koko-PhyuHtwe/electronic-shifter-mbd/Shift-by-Wire_手册/01_项目概览与架构.md

# 第 1 章：项目概览与架构

## 项目定位

一句话：**用两颗车规 MCU + 一条 500kbps CAN，把一根电子摇杆变成能驱动实体换挡执行器的线控换挡系统，并把中间每一步的决策依据都暴露在串口屏上。**

面试定位提醒：这不是"点灯 + 串口打印"的教学工程。它同时具备四个量产项目的必备特征——**模型自动生成的控制逻辑、跨 MCU 的通信协议、双端独立的故障降级、以及可复现的调试记录**。

## 属性表

| 项目 | 内容 |
|---|---|
| 系统名称 | BMW Shift-by-Wire HIL 台架 |
| 拓扑 | 双 ECU：S32K144（采集 + 决策）↔ STM32G474VET6（执行 + 反馈） |
| 建模工具 | Simulink / Stateflow，`ert.tlc`，定步长 10ms |
| 生成代码 | `GearShift_Stateflow_step()` 纯函数式，被 FreeRTOS 任务以 10ms 调用 |
| 两片 RTOS | FreeRTOS（S32K 侧 7 任务 / G474 侧 5 线程，均为 CMSIS-RTOS v2 封装） |
| 通信 | Classic CAN 2.0A，500kbps，0x180 / 0x280 周期 10ms |
| 人机界面 | Nextion 串口屏，115200，指令式（`n0.val=` / `t0.txt=`） |
| 执行机构 | 舵机（PWM 50Hz，500~2500µs 对应 0~180°） |
| 安全机制 | 双端通信看门狗（0.5s / 2s 两级）、两侧独立看门狗（G474 1.25s / S32K 1.0s）、执行侧重启锁存 + 非法指令拦截、FAULT 状态 |
| 建模→实物闭环 | 摇杆三态（0/1/2）→ 状态机 → CAN → 舵机角度 → 屏幕显示 |

## 模块依赖图

```
                    ┌──────────────── S32K144 ────────────────┐
  摇杆 x/y (ADC) ──►│ sbw_adc.c ──► g_stick_x / g_stick_y      │
  刹车/油门 (ADC)──►│ (上电自校准 + 迟滞 + 4点滑窗)            │
  P键/解锁键(GPIO)►│ sbw_buttons.c ──► g_p_button/g_unlock    │
                    │                                          │
                    │        ┌──────────────┐                  │
                    │        │ rtos.c       │ 7 tasks          │
                    │        │ vTask_Gear   │ 10ms             │
                    │        └──────┬───────┘                  │
                    │               ▼                          │
                    │  GearShift_Stateflow_step()  ← 生成码    │
                    │   （6 顶层态 + M 内 6 子态）             │
                    │               │ current_gear             │
                    │               ▼                          │
                    │  sbw_can.c ──► 0x180 (10ms) ──┐          │
                    │  sbw_hmi.c ◄── Nextion 指令   │          │
                    │  sbw_veh.c ──► rpm/speed 仿真 │          │
                    └───────────────────────────────┼──────────┘
                                                    │ CAN 500k
                    ┌───────────────────────────────▼──────────┐
                    │            STM32G474VET6                 │
                    │  fdcan.c  RX FIFO0 过滤 0x180 ──► g_target│
                    │  app_freertos.c                          │
                    │    vTask_Servo_Control 10ms              │
                    │      GearToAngle() → ServoAngleToPulse() │
                    │      TIM3_CH1 / PE2 / 50Hz               │
                    │    vTask_CAN_Tx 10ms ──► 0x280           │
                    │    vTask_Debug 100ms ──► USART1          │
                    │  iwdg.c 1.25s 看门狗                     │
                    └──────────────────────────────────────────┘
```

## 核心文件速查

| 文件 | 行数 | 职责 | 面试必问 |
|---|---|---|---|
| `src/rtos.c` | 872 | 任务创建、输入映射、CAN 收发任务、演示面板 | 为什么 CANRx 优先级最高？ |
| `src/GearShift_Stateflow.c` | 721 | 生成码：全部换挡逻辑 | 生成码怎么读？`UnitDelay1` 干什么？ |
| `src/sbw_adc.c` | 317 | 4 路 ADC、滤波、摇杆自校准 | 为什么回中值 2936 不能用固定阈值？ |
| `src/sbw_can.c` | 315 | FlexCAN 初始化、环形队列、错误诊断 | 为什么用队列而不是直接读？ |
| `src/sbw_hmi.c` | 320 | Nextion 指令封装 + 接收解析 | `0xFF 0xFF 0xFF` 是什么？ |
| `src/sbw_buttons.c` | 80 | 双键消抖，极性参数化 | 为什么极性要做成参数？ |
| `src/sbw_veh.c` | 375 | 6 挡手动变速器物理模型 | 极速怎么标定的？ |
| `src/sbw_wdog.c` | 105 | WDOG 寄存器封装 + 复位原因采集 | 喂狗为什么挂心跳而不是 CAN？ |
| `STM32.../app_freertos.c` | 606 | 舵机 + 电机 PWM、CAN 组帧、喂狗 | 超时为什么是"冻结"不是"归位"？ |

## 版本演进

| 阶段 | 内容 | 状态 |
|---|---|---|
| P0 | Simulink/Stateflow 建模 + 生成码 | ✅ 完成（v1.24） |
| P1 | S32K144 采集侧集成（ADC/按键/CAN/HMI） | ✅ 完成 |
| P2 | G474 执行侧集成（CAN/舵机/IWDG） | ✅ 完成 |
| P3 | 双 ECU 联调（CAN 互通、换挡全链路） | ✅ 完成 |
| P4 | HIL 验证（摇杆校准、故障注入、演示面板） | 🟡 进行中 |
| P5 | CAN FD 升级（当前为 Classic CAN） | ⬜ 未开始 |

## 三个关键设计取舍

**① 为什么拆两颗 MCU，而不是一颗跑全部？**
一号理由不是算力，是**时序隔离**。舵机 PWM 由硬件定时器直接产生，但"什么时候改 CCR"发生在任务上下文；如果决策逻辑与舵机控制共享 CPU，任何一次 Stateflow 生成码里的长分支（M 挡 6 个子态的连锁判断）都会引入抖动。拆开后 G474 只需保证 10ms 周期内几十行代码，S32K 侧再怎么改模型都影响不到 PWM 的相位。副产品是**两个天然独立的故障判定点**——这正是功能安全想要的。

**② 为什么用 Classic CAN 500k 而不是 CAN FD？**
当前报文用掉 7 字节（档位/显示/生命计数/车速/油门/刹车），Classic CAN 的 8 字节刚好；500k 下单帧约 111 bit，10ms 周期单方向占用 2.2%、双向约 4.5%。上 FD 的收益要等到"把全部 ADC 原始值 + 诊断码 + 时间戳一起广播"才有意义，规划里放在 P5。

**③ 为什么换挡逻辑用 Stateflow 生成码，而不用手写 if-else？**
因为换挡是**状态机**而不是流程。手写 `if-else` 半年后没人能说清"从 M3 到 D 有几条路径"。Stateflow 保证每个状态的出边都在一张图里，且生成码天然带有"状态变量 + 转移守卫"的结构，便于 review 和覆盖率统计。代价是生成码可读性差，所以第 3 章专门讲怎么读它。

---

**下一章**：[02_硬件平台与引脚定义.md](./02_硬件平台与引脚定义.md) —— 两颗 MCU 的完整引脚、电气极性实测、以及"共地"这个害了两天的坑。
