koko-PhyuHtwe/electronic-shifter-mbd/Shift-by-Wire_手册/02_硬件平台与引脚定义.md

# 第 2 章：硬件平台与引脚定义

## 两颗 MCU 的基本盘

| 项目 | S32K144（采集 + 决策） | STM32G474VET6（执行 + 反馈） |
|---|---|---|
| 内核 | Cortex-M4F @80MHz | Cortex-M4F @80MHz（FPU + DSP） |
| Flash / RAM | 512KB / 64KB | 512KB / 128KB |
| 封装 | LQFP100 | LQFP100 |
| 时钟源 | 外部晶振 8MHz → PLL | 外部晶振 8MHz → PLL |
| 总线时钟 | CORE 80MHz / BUS 40MHz | SYSCLK 80MHz / PCLK1 80MHz |
| RTOS | FreeRTOS 10.x（heap 20KB，tick 1000Hz） | FreeRTOS 10.x（heap 4KB，tick 1000Hz） |
| 开发环境 | S32 Design Studio 3.6.8 | STM32CubeIDE |
| 配置工具 | NXP 配置工具（生成 `board/`） | CubeMX（生成 `Core/`） |

## S32K144 引脚表（LQFP100）

| 功能 | 引脚 | 脚号 | 模式 | 复用/上下拉 | 备注 |
|---|---|---|---|---|---|
| 摇杆 X | **PTC2** | 30 | Analog | ADC0_SE10 | 电位器滑臂 |
| 摇杆 Y | **PTC3** | 29 | Analog | ADC0_SE11 | 电位器滑臂 |
| 刹车踏板 | **PTA6** | 58 | Analog | ADC0_SE2 | 0~100% |
| 油门踏板 | **PTA7** | 57 | Analog | ADC0_SE3 | 0~100% |
| P 档键 | **PTB4** | 28 | GPIO 输入 | 内部**上拉** | **低有效**（实测松开 3.3V、按下 0V） |
| 解锁键 | **PTB2** | 48 | GPIO 输入 | 内部**下拉** | **高有效**（实测松开 0.76V、按下 3.3V） |
| CAN2 RX | **PTC16** | 44 | ALT3 | — | 接 CAN 收发器 RXD |
| CAN2 TX | **PTC17** | 43 | ALT3 | — | 接 CAN 收发器 TXD |
| HMI RX | **PTC6** | 81 | ALT2 | LPUART1_RX | 接屏幕 TX |
| HMI TX | **PTC7** | 80 | ALT2 | LPUART1_TX | 接屏幕 RX |
| 绿 LED | PTD16 | — | GPIO 输出 | — | CAN 初始化失败指示 |
| 蓝 LED | PTD15 | — | GPIO 输出 | — | 心跳 |
| 红 LED | PTD0 | — | GPIO 输出 | — | 备用 |
| 旧按键（未用） | PTC12/13/14 | — | GPIO 输入上拉 | — | 早期方案残留 |

> ADC 分辨率 12 位（0~4095），ADC0 时钟 8MHz，`sampleTime = 255`。

## STM32G474VET6 引脚表（LQFP100）

| 功能 | 引脚 | 模式 | 复用 | 备注 |
|---|---|---|---|---|
| 舵机 PWM | **PE2** | AF 推挽 | TIM3_CH1 / AF2 | 50Hz，500~2500µs |
| 电机 PWM | **PE3** | AF 推挽 | TIM3_CH2 / AF2 | 50Hz，1000~2000µs（标准 RC 电调信号） |
| CAN RX | **PB12** | AF | AF9 | 接 CAN 收发器 RXD（FDCAN2 外设，经典帧模式） |
| CAN TX | **PB13** | AF | AF9 | 接 CAN 收发器 TXD |
| 调试 TX | PA9 | AF | USART1 / AF7 | 115200-8-N-1 |
| 调试 RX | PA10 | AF | USART1 / AF7 | |
| 蓝 LED | PE0 | GPIO 输出 | — | 1s 心跳 |
| 绿 LED | PE1 | GPIO 输出 | — | CAN 状态指示 |
| ADC1 IN1~IN4 | — | Analog | — | DMA 到 `g_adc_buffer[4]`，**当前未消费** |

## 外部器件清单

| 器件 | 接口 | 关键参数 |
|---|---|---|
| 摇杆（双轴电位器） | S32K ADC0_SE10/SE11 | 3.3V 供电，回中约 2900~3050（**不是 2048**） |
| 刹车踏板（霍尔/电位器） | ADC0_SE2 | 0~100%，>30% 才算"踩下" |
| 油门踏板 | ADC0_SE3 | 0~100%，死区以下 200 counts 视为 0 |
| 解锁键（自复位） | PTB2 | 按下接 3.3V，板上有外部下拉 |
| P 档键（自复位） | PTB4 | 按下接 GND，板上有外部上拉 |
| 舵机 | G474 PE2 | 5V 供电，PWM 50Hz，0°=换挡机构 P 位 |
| 电机 + 电调 | G474 PE3 | Sunnysky X2212 KV1400 + 好盈 20A 电调，信号线接 PE3，**黑线必须共地** |
| 串口屏 | S32K PTC6/PTC7 | Nextion，115200，**工程文件为私有二进制** |
| CAN 收发器 ×2 | 两侧各一 | 3.3V 逻辑，终端电阻 120Ω ×2 |

## 电气极性：两个按键为什么不一样

这是本项目最容易被误判的地方，两个键在同一块板子上，极性相反：

| 按键 | 松开实测 | 按下实测 | 结论 | 配置 |
|---|---|---|---|---|
| 解锁键 PTB2 | **0.76 V** | 3.3 V | 高有效 | 内部下拉（把 0.76V 压到 ~0V） |
| P 档键 PTB4 | **3.3 V** | 0 V | 低有效 | 内部上拉 |

0.76V 的来历：按键接 3.3V，板上有 ~10k 外部下拉，芯片内部又是 ~30k 上拉，两者分压。关键结论是：**0.76V 低于 MCU 的 VIL 典型值（约 0.99V）但余量只有 0.23V**，任何噪声都可能误触发。把内部上拉改成下拉后，静态电平被压到 ~0V，噪声余量从 0.23V 提升到 1V 以上。

> 代码里这个"极性"做成了**编译期常量**（`BTN_P_ACTIVE_LEVEL` / `BTN_UNLOCK_ACTIVE_LEVEL`），而不是硬编码 `!HAL_GPIO_ReadPin(...)`。理由见第 11 章踩坑记录——硬编码极性导致过两次"按键永远按下 / 永远不响应"的误诊。

## 三个硬件层面的坑

**① 共地**：摇杆电位器的 GND 悬空时，ADC 读数只有在"两轴同时构成回路"（对角推动）时才正常。表现是"必须斜着推才有反应"。这不是软件问题，任何滤波都救不了——**模拟量的第一课是共地**。

**② 舵机电源与逻辑电源分离**：舵机堵转电流可达 1A 以上，如果与 MCU 共用 5V LDO，换挡瞬间会拉低 MCU 电源造成复位。台架上必须给舵机独立 5V。电调的 BEC 5V 同理，**不要与板子 5V 并联**（拔红线或单独供电，但必须共地）。

**③ CAN 终端电阻**：两侧各 120Ω，总线两端各一个。只在一端装或两端都不装时，短距离还能通信，但示波器上能看到明显的振铃，长线必挂。

---

**上一章**：[01_项目概览与架构.md](./01_项目概览与架构.md) ｜ **下一章**：[03_Stateflow模型与代码生成.md](./03_Stateflow模型与代码生成.md)
