koko-PhyuHtwe/electronic-shifter-mbd/Shift-by-Wire_手册/14_文件组织指南.md

# 第 14 章：文件组织指南

## 顶层结构

```
bmw-shift-by-wire-hil/
├── README.md                  # 项目入口（架构 / 协议 / 上手指南）
├── MATLAB/                    # Simulink/Stateflow 模型与生成码
├── S32K144/                   # 采集 + 决策侧
└── STM32G474VET6/             # 执行 + 反馈侧
```

> 本手册现在放在**工程同级的** `Documents/Shift-by-Wire_手册/`，不带在仓库里——方便单独拷给面试官或打印，也避免和代码混在一起。

## MATLAB/

| 文件 | 作用 | 能否删 |
|---|---|---|
| `GearShift_Stateflow.slx` | **模型源文件**（约 230KB，v1.24） | ❌ 不能，唯一原件 |
| `GearShift_Stateflow_ert_rtw/` | Ctrl+B 的产物目录（`.c/.h/_private.h/_types.h/rtwtypes.h` 都在这里） | ⚠️ 拷进 `src/` 后可以删，但留着方便下次对比 |
| `slprj/`、`*.slxc`、`binfo.mat`、`codeInfo.mat`、`bundle*.js` | Simulink 构建缓存（66 个文件，约 2.9MB） | ✅ 可删（重新生成会再出现） |

> **注意**：`MATLAB/GearShift_Stateflow_ert_rtw/` 下的 `.c/.h` 与 `S32K144/freertos_s32k144/src/` 下的同名文件是**两份副本**。编译用的是 `src/` 那份，改完模型要手动拷过去——这是当前流程最脆弱的一环，忘了拷就会出现"模型改了但幺幺没变"。

## S32K144/freertos_s32k144/src/ —— 手写代码

| 文件 | 行数 | 作用 | 关键点 |
|---|---|---|---|
| `main.c` | 41 | 只有 `rtos_start()` + 不会返回的兜底循环 | 尽量空，避免逻辑分散 |
| `rtos.c` | 872 | 7 任务、输入映射、CAN 收发、活体计数喂狗、演示面板 | 系统主骨架 |
| `sbw_adc.c/.h` | 317 / 60 | 4 路 ADC、滤波、摇杆自校准 | `ADC_ToStickPos()` 是核心 |
| `sbw_can.c/.h` | 315 / 130 | FlexCAN 初始化、环形队列、错误状态与计数器 | `CAN_Init()` 失败点亮绿 LED |
| `sbw_hmi.c/.h` | 320 / 73 | Nextion 指令收发 | 三个 `0xFF` 帧尾 |
| `sbw_buttons.c/.h` | 80 / 58 | 双键消抖，极性参数化 | `activeLevel` 参数 |
| `sbw_veh.c/.h` | 375 / 47 | 6 挡手动车辆模型 | `VehModel_Update(gearCode)` |
| `sbw_wdog.c/.h` | 105 / 52 | WDOG 寄存器级封装（1.0s）+ 复位原因采集 | 喂狗由心跳任务在活体检查后调用 |
| `GearShift_Stateflow.c` | 721 | 生成码：全部换挡逻辑（模型 v1.24，无手改） | 不要手改，改模型 |
| `GearShift_Stateflow.h` | 138 | `ExtU`（9 进）/ `ExtY`（2 出）定义 | 接口变更会编译报错 |
| `GearShift_Stateflow_private.h` | 26 | 生成码私有定义 | |
| `GearShift_Stateflow_types.h` | 28 | 生成码类型 | |
| `rtwtypes.h` | 176 | Simulink 基础类型 | |
| `BoardDefines.h` | 30 | 板级宏 | |

## S32K144/freertos_s32k144/board/ —— 配置工具生成

| 文件 | 作用 | 改法 |
|---|---|---|
| `clock_config.c/.h` | 时钟树（CORE 80MHz / BUS 40MHz / ADC0 8MHz） | 用配置工具改，不要手改 |
| `pin_mux.c/.h` | 引脚复用、上下拉 | **可以手改**（本项目改过 PTB2 的上下拉） |
| `peripherals_adc_config_1.c/.h` | ADC 通道配置（4 个通道结构体） | 配置工具 |
| `peripherals_flexcan_config_1.c/.h` | FlexCAN 位时序 | 配置工具 |
| `peripherals_lpuart_1.c/.h` | LPUART1（HMI） | 配置工具 |
| `peripherals_FreeRTOS.c/.h` | FreeRTOS 配置包装 | 配置工具 |
| `peripherals_osif_1.c/.h` | OSIF（裸机/RTOS 抽象） | 配置工具 |
| `sdk_project_config.h` | 汇总包含所有外设配置 | **已经包含 pin_mux.h**（所以别重复 include） |
| `FreeRTOSConfig.h` | heap 20KB、tick 1000Hz、优先级 5 | 手改（注意 `configLIBRARY_MAX_SYSCALL_INTERRUPT_PRIORITY`） |

## STM32G474VET6/ShiftByWire_HIL/Core/Src/

| 文件 | 行数 | 作用 | 关键点 |
|---|---|---|---|
| `main.c` | 237 | 初始化顺序 + `osKernelStart()` | `MX_TIM3_Init` 里已启动 CH1；CH2 由 `Motor_Init()` 启动 |
| `app_freertos.c` | 606 | 舵机控制、电机 PWM、CAN 组帧、喂狗 | `last_gear = 0xFF` 初值 |
| `fdcan.c` | 292 | CAN 500kbps、过滤器、**bus-off 自愈回调** | `AutoRetransmission = DISABLE` |
| `tim.c` | 152 | TIM3 50Hz PWM，PE2/PE3 AF2 | PSC 79 / ARR 19999 |
| `iwdg.c` | 59 | 独立看门狗 1.25s | Prescaler 64 / Reload 625 |
| `adc.c` | 210 | ADC1 4 通道 DMA | **采集了但没消费** |
| `usart.c` | 153 | USART1 115200 | 调试打印 |
| `gpio.c` | 67 | LED | |
| `stm32g4xx_it.c` | 208 | 中断向量 | CAN/SysTick |
| `stm32g4xx_hal_timebase_tim.c` | 127 | HAL 时基（TIM2） | |
| `system_stm32g4xx.c` | 287 | 时钟初始化 | |
| `dma.c` | 56 | DMA | ADC 用 |
| `stm32g4xx_hal_msp.c` | 87 | HAL MSP | |

> G474 侧除了 USER CODE 区，**其余都是 CubeMX 生成物**。要改外设就回 CubeMX 改，否则下次生成会被覆盖。

## 哪些文件可以安全删除

| 文件 | 理由 |
|---|---|
| `MATLAB/slprj/`、`*.slxc`、`*.mat`、`bundle*.js` | 构建缓存（约 2.9MB） |
| `Debug_FLASH/` 下的 `.o` / `.d` / `.elf` | 编译产物（但保留 `.args`，命令行复编译要用） |
| `STM32G474VET6/.../Drivers/` 里没用到的 HAL 模块 | 体积大头（全工程 158MB） |
| `S32K144/.../Debug_FLASH/src/*.d` | 依赖文件，重新编译会生成 |

## 哪些文件绝对不能删

1. `MATLAB/GearShift_Stateflow.slx` —— 模型唯一原件。
2. `board/sdk_project_config.h` —— 所有外设配置的入口，删了编译全崩。
3. `board/FreeRTOSConfig.h` —— 优先级和堆配置，直接影响调度行为。
4. `src/GearShift_Stateflow.c` —— 即便能重新生成，也要保证仓库里有一份可编译的。

## 命名与目录约定

- **模块前缀**：`sbw_` 表示"本项目自写的业务模块"，与 NXP/ST 生成文件（`peripherals_*`、`MX_*`、`board/`）区分开。
- **生成文件不手改**：`GearShift_Stateflow.*`、`board/clock_config.*`、`board/peripherals_*` 都是生成的。唯一例外是 `pin_mux.c`（改上下拉），因为配置工具的 UI 不好用。
- **一行一个职责**：`rtos.c` 里每个任务函数只做一件事，不做嵌套调用，方便定位问题。
- **命名**：函数 `模块_动作`（`ADC_SampleAll`）、全局量 `g_` 前缀、文件内静态量 `s_` 前缀、宏全大写且数值带 `U` 后缀。
- **格式**：S32K 侧 LF + 4 空格，G474 侧跟随 ST 的 CRLF + 2 空格；大括号 Allman 风格；只用 `/* */`，不用 `//`；行宽 ≤100。

## 编译产物与 `.args`

`Debug_FLASH/src/GearShift_Stateflow.args` 是 S32DS 生成的编译参数文件（include 路径、宏定义、优化选项）。它的用途是**不开 IDE 也能编译单个文件**：

```powershell
cd S32K144/freertos_s32k144/Debug_FLASH
arm-none-eabi-gcc.exe @src/GearShift_Stateflow.args -o out.o ..\src\rtos.c
```

这在快速验证语法错误时非常有用——IDE 启动要 30 秒，命令行编译 2 秒。

---

**上一章**：[13_面试问答.md](./13_面试问答.md) ｜ **返回**：[README.md](./README.md)
