koko-PhyuHtwe/electronic-shifter-mbd/Shift-by-Wire_手册/12_工程规范与改进方向.md

# 第 12 章：工程规范与改进方向

## 已实现（可以拍胸脯的）

| 能力 | 证据 |
|---|---|
| Stateflow 建模 + 自动生成码落地 | `GearShift_Stateflow.c` 721 行，被 10ms 任务调用 |
| 6 状态机 + 6 手动子态 | P/R/N/D/M1~M6/FAULT 全部可达 |
| 双 MCU 跨 CAN 通信 | 0x180 / 0x280，10ms 周期，实测互通 |
| 摇杆上电自校准 + 迟滞 | 回中 2936 也能正确判三态 |
| 4 路 ADC + 滤波 + 死区 | 刹车/油门/摇杆 X/Y |
| 按键极性参数化 + 消抖 | 30ms 消抖，两个相反极性的键共存 |
| 串口屏 HMI | 数字/文本控件、指令封装、接收解析 |
| 双端通信看门狗 | G474 500ms 冻结 / S32K 2s 进 FAULT |
| 独立看门狗 | G474 IWDG 1.25s / S32K WDOG 1.0s（任务活体检测，**代码就绪、当前关闭**） |
| 6 挡手动车辆模型 | 齿比/扭矩曲线/半联动/断油/发动机制动 |
| 演示面板 | 大档位 + 事件日志，横屏布局 |
| 电机通道 | TIM3_CH2 → 电调，0x180 B5 传油门，3s 解锁 + 见过 B5==0 |
| 动力安全四道闸 | 失联/FAULT 软切（锁存）、挡位门、刹车优先、台架限幅 |

## 已实现（曾经的风险，现已关闭）

| 曾有的缺口 | 现在的做法 | 代码位置 |
|---|---|---|
| 行驶中复位 → 回 P → 舵机拉到 P | 0x180 增车速字节；G474 用「life 计数不连续」+「车速单帧暴跌 >10km/h」判定对端重启，行驶中触发则锁存拒绝 P/R，并上报 `EXEC LOCK` | `Core/Src/fdcan.c` 回调、`Core/Src/app_freertos.c` 舵机任务 |
| S32K 调度器卡死 → 永久失去响应 | WDOG 1.0s + 心跳任务的五任务活体检测；喂狗与 CAN 状态无关，避免断线引起复位循环 | `src/sbw_wdog.c`、`src/rtos.c` `vTask_Heartbeat` |

## 未实现（必须诚实标注的）

| 缺口 | 影响 | 优先级 |
|---|---|---|
| 舵机无位置反馈 | 舵机卡死/断线在软件上不可见 | **高** |
| 无复位原因计数 | 反复复位时无"锁定维护"出口（工业做法：后备寄存器计数 + DTC） | 中 |
| S32K 侧不校验 life_counter | 无法检测丢帧/重复帧（G474 侧已用于重启检测） | 中 |
| 无 E2E 保护（CRC/DataID） | 不满足 ASIL-B 的通信安全 | 中 |
| 无 DTC / 诊断服务 | 无法读故障码 | 中 |
| 无 Bootloader | 不能 OTA 刷写 | 低（已有独立 UDS 工程） |
| P→N 直接通路缺失 | 与真车行为有差异 | 低 |
| M 模式无 N 出口 | 只能回 D 或 P | 低 |
| CAN FD 未升级 | 带宽利用率低 | 低（P5 规划） |
| G474 ADC 采集了不用 | 死代码 | 低 |

## 代码规范

### 命名

| 前缀/形式 | 含义 | 例 |
|---|---|-----|
| `g_` | 全局变量 | `g_current_gear` |
| `s_` | 文件内静态变量 | `s_throttle` |
| `vTask_` | FreeRTOS 任务函数 | `vTask_Gear_Logic` |
| `MX_` | CubeMX 生成 | `MX_FDCAN2_Init` |
| `sbw_` | 本项目自写模块 | `sbw_adc.c` |
| 全大写 | 宏 | `ADC_DEAD_LOW` |
| `Module_Function` | 模块内函数 | `ADC_ToStickPos` |

### 三条硬规则

1. **跨任务共享的变量必须 `volatile`**。当前全是 8/16 位整数，读写原子；若将来加结构体，必须改用队列。
2. **ISR 里只做搬运，不做业务**。CAN 中断只入队，HMI 中断只填环形缓冲。
3. **极性、阈值、周期一律宏定义在头文件**，不写魔法数字。`git diff` 要能一眼看出"改了哪个阈值"。

### 编译零警告

S32K 侧 9 个源文件用 `arm-none-eabi-gcc` 单独编译全部 0 warning。命令行复编译方法见 README。**提交前必须零警告**——警告里藏着真实的类型截断和未初始化变量。

## 改进路线图

### 短期（P4 收尾，1~2 天）

1. ~~**0x180 加车速字节**~~：已完成（`B4 = vehicle_speed` + G474 侧重启检测与拒绝执行）。
2. ~~**启用 S32K WDOG**~~：代码已完成（`sbw_wdog.c`，1.0s，心跳任务五任务活体检测后喂），**当前 `WDOG_ENABLE` 还是 `0U`**——排查复位循环时关的，稳定后改回 `1U` 并跑一遍故障注入。
3. **跑完动力软切的 A/B/C 测试**：拔 CAN 软切、插回不自动恢复、松脚重踩恢复。
4. **接收侧校验 life_counter**：连续 3 次不 +1 → 计一次通信异常（G474 侧已用于重启检测，S32K 侧尚未做）。
5. **复位原因计数**：后备寄存器存上电次数，10 分钟内 >3 次进锁定维护态。

### 中期（P4.5，1 周）

6. **加舵机反馈电位器**：接到 G474 ADC1 IN1，`g_adc_buffer[0]` 与目标角度比较，偏差 >5° 持续 200ms → `STATUS_SERVO_FAULT`。
7. **加 DTC 表**：至少 6 条（通信丢失、超时、舵机偏差、摇杆开路、欠压、看门狗复位）。通过 HMI 或调试串口读。

> status 位回传已经做完了：`0x280.B2` 的 bit1/bit3/bit4/bit5 在 S32K 屏上分别显示为 `EXEC LOCK` / `PWR CUT` / `NO DRIVE` / `BRAKE CUT`。

### 长期（P5）

8. **CAN FD 升级**：把载荷从 7 字节扩到"全部原始 ADC + 诊断码 + 时间戳"，周期从 10ms 降到 5ms。
9. **E2E 保护**：CRC8 + 计数器 + DataID，符合 AUTOSAR E2E Profile 1/2。
10. **Bootloader**：复用已完成的 UDS Bootloader 工程（`S32K144_UDS_Bootloader`），加 OTA 刷写。
11. **ASIL 分析**：做 HARA，识别"非预期换入 P"的 ASIL 等级，反推安全机制。

## 量产还差什么（面试常问）

如果问"这个项目离量产还有多远"，按这个顺序答：

1. **功能安全**：当前无 HARA、无 FMEA、无安全手册。至少要识别出"非预期换挡"的 ASIL 等级，并证明现有的互锁与超时机制能满足。
2. **E2E 通信保护**：CAN 硬件 CRC 不够，需要应用层 CRC + 计数器，能检出"内容正确但顺序错乱"的帧。
3. **传感器冗余**：摇杆单路模拟量，一路断线就失去输入。量产需要双路互检或数字编码器。
4. **执行器闭环**：舵机必须带位置反馈，"指令=实际"才能被证明。
5. **诊断与可维护性**：DTC、冻结帧、UDS 服务（0x19/0x22/0x2E）、Bootloader。
6. **环境与 EMC**：温度循环、振动、ESD、BCI。台架上跑通不代表车上能跑。
7. **软件过程**：MISRA C、单元测试覆盖率、静态分析（Polyspace/Coverity）、需求可追溯性。

## 这个项目真正证明了什么

不是"我会用 FreeRTOS"，而是：

- **能把一个 Simulink 模型变成两片 MCU 上跑起来的实物**——闭环从建模到执行器。
- **能在没有逻辑分析仪、只有万用表和串口屏的条件下定位问题**——坑 #4 的两天和坑 #6 的"没烧录"。
- **知道哪里没做完，以及为什么没做完**——这份清单本身就是工程能力的证据。

---

**上一章**：[11_调试踩坑记录.md](./11_调试踩坑记录.md) ｜ **下一章**：[13_面试问答.md](./13_面试问答.md)
