koko-PhyuHtwe/electronic-shifter-mbd/.archify/explainer-sbw-hil-20261107-000500/t1.md

# 测试 {#t}

结论。

@answer scope="测试"
@meta locale=zh-CN style=clean

@source readme title="README" path=README.md

## 面板 {#p}

文字。[]
