koko-PhyuHtwe/electronic-shifter-mbd/.archify/explainer-sbw-hil-20261107-000500/full-light.png

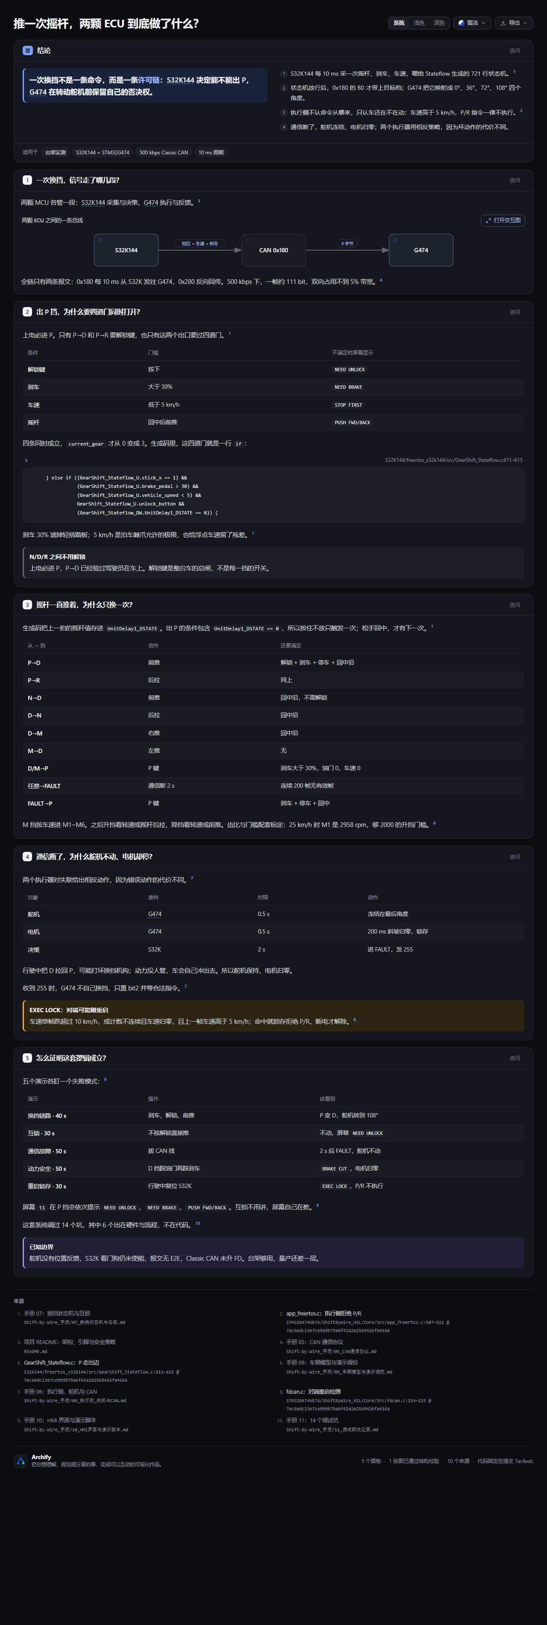
.archify/explainer-sbw-hil-20261107-000500/full-light.png
