koko-PhyuHtwe/electronic-shifter-mbd/.archify/explainer-sbw-hil-20261107-000500/shots2/shift-by-wire-hil.visual-check.1280x900.dark.png

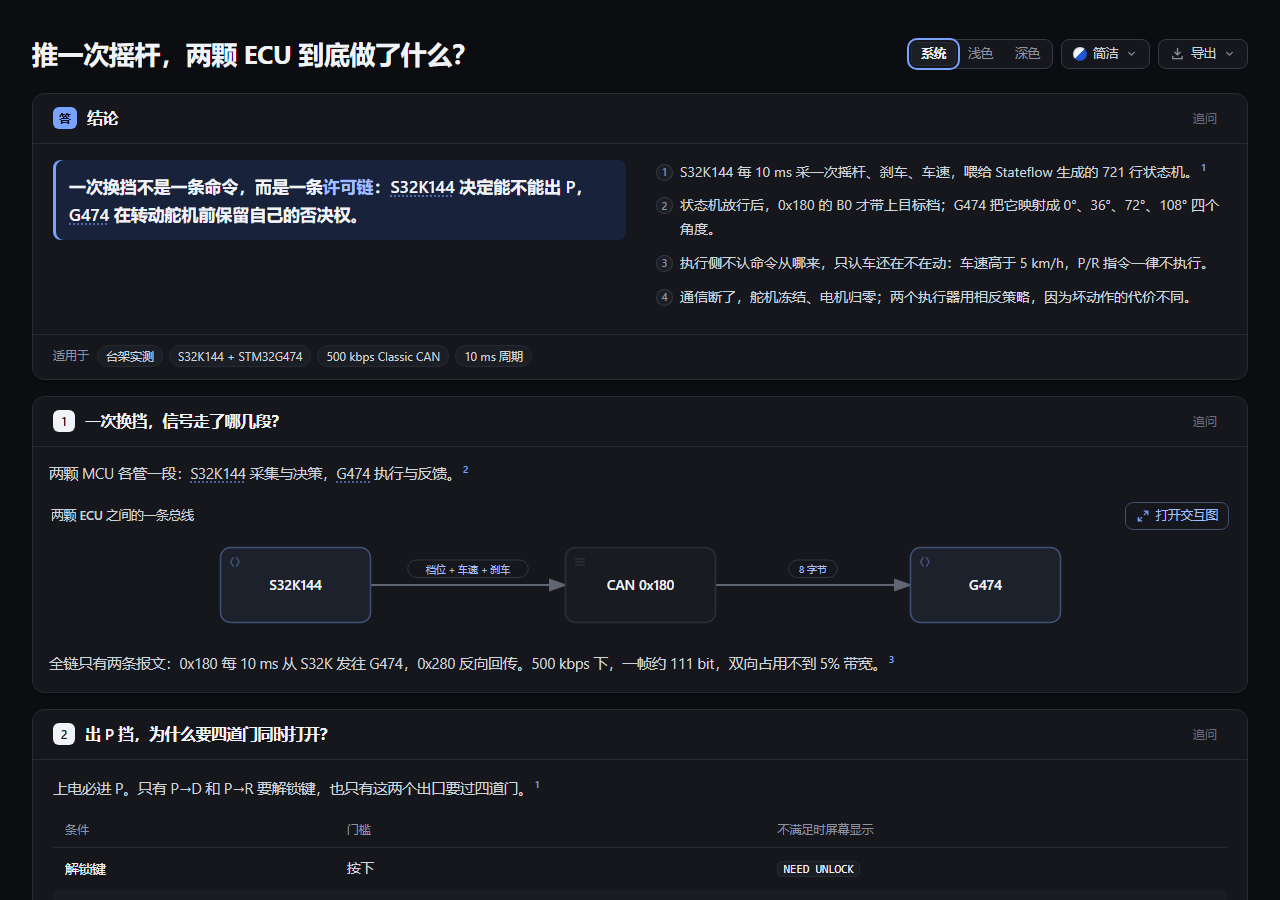
.archify/explainer-sbw-hil-20261107-000500/shots2/shift-by-wire-hil.visual-check.1280x900.dark.png
