koko-PhyuHtwe/electronic-shifter-mbd/.archify/explainer-sbw-hil-demo-20261107-003300/full.png

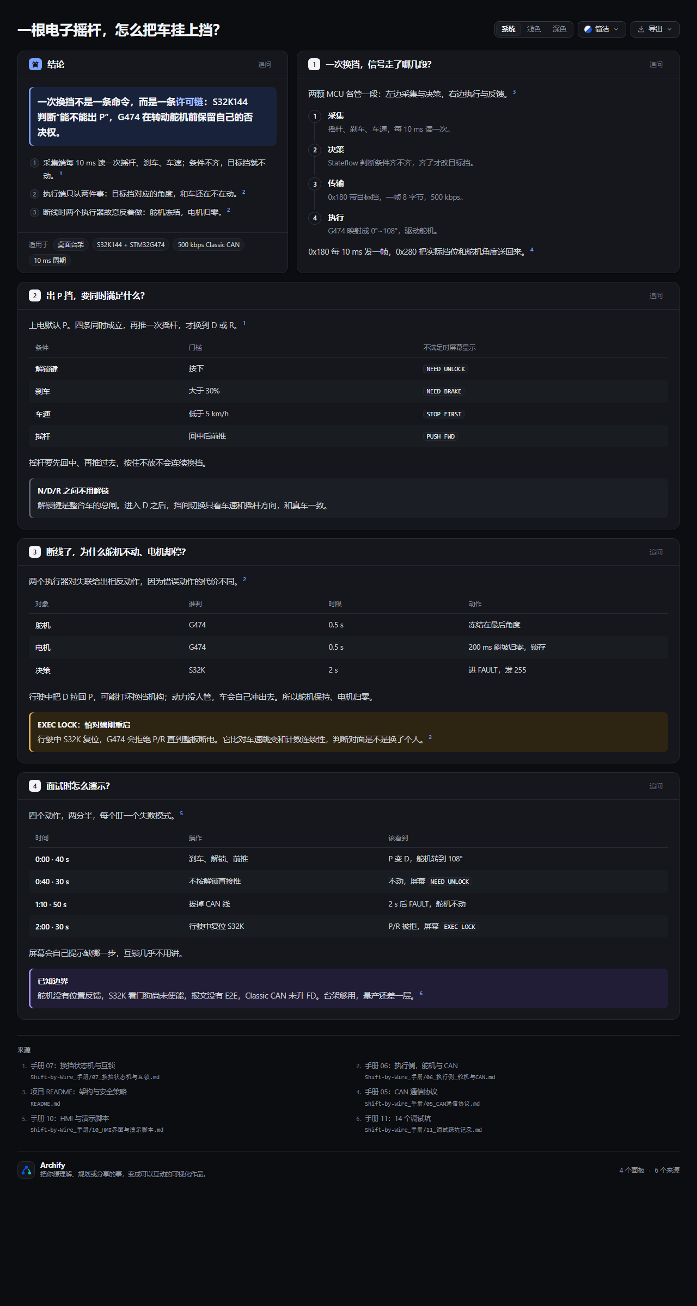
.archify/explainer-sbw-hil-demo-20261107-003300/full.png
