koko-PhyuHtwe/electronic-shifter-mbd/.archify/explainer-sbw-hil-demo-20261107-003300/shots/shift-by-wire-hil-demo.visual-check.1280x900.dark.png

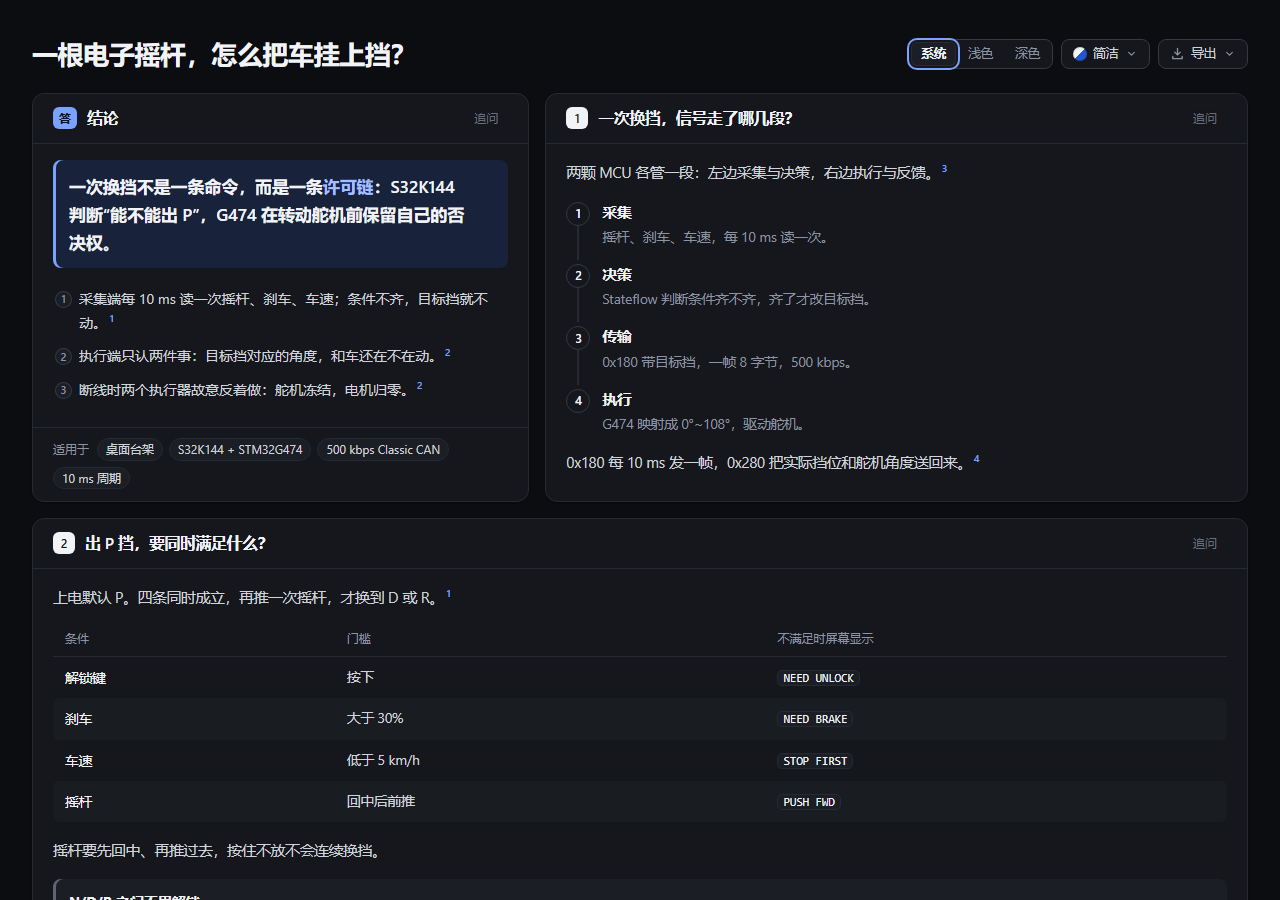
.archify/explainer-sbw-hil-demo-20261107-003300/shots/shift-by-wire-hil-demo.visual-check.1280x900.dark.png
