koko-PhyuHtwe/electronic-shifter-mbd/.archify/final.png

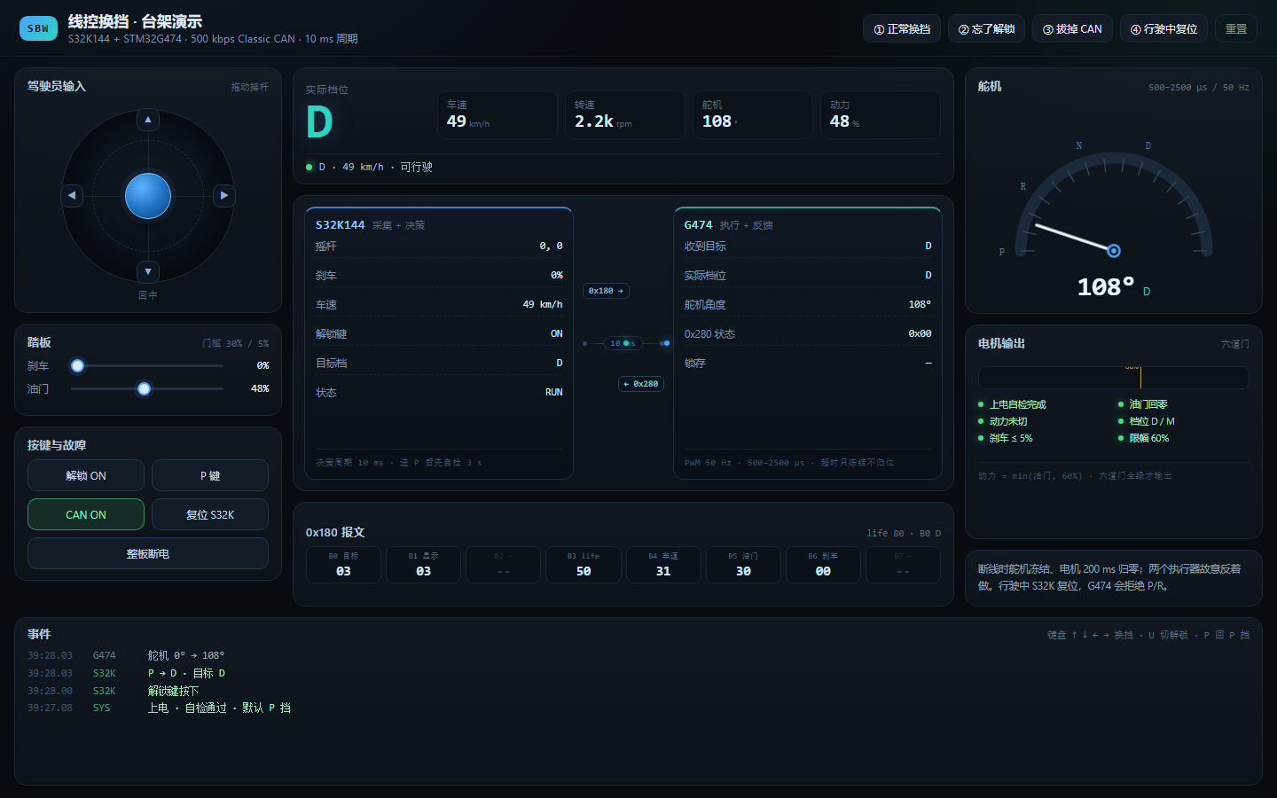
.archify/final.png
