koko-PhyuHtwe/electronic-shifter-mbd/.archify/top.png

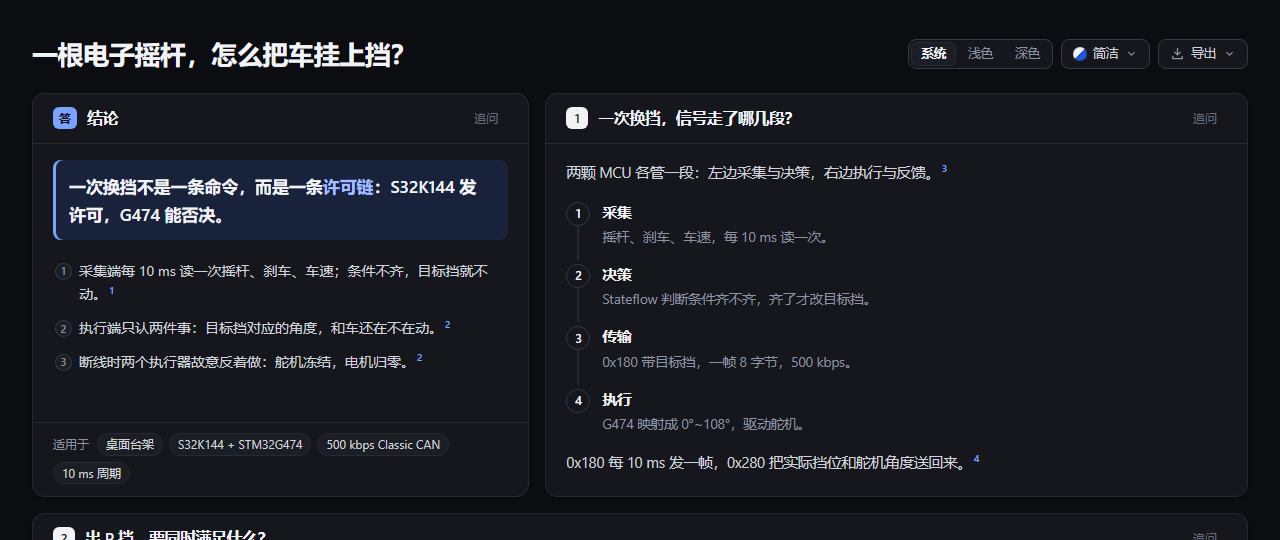
.archify/top.png
