koko-PhyuHtwe/electronic-shifter-mbd/.archify/explainer-sbw-hil-demo-20261107-003300/measure.html

跳至正文

# 一根电子摇杆，怎么把车挂上挡？

系统浅色深色

简洁

简洁杂志产品网格

导出

长图

PNG最清晰WebP体积最小JPG兼容最好

打印 / PDF

答

## 结论

一次换挡不是一条命令，而是一条许可链：S32K144 判断“能不能出 P”，G474 在转动舵机前保留自己的否决权。

1. 采集端每 10 ms 读一次摇杆、刹车、车速；条件不齐，目标挡就不动。¹
2. 执行端只认两件事：目标挡对应的角度，和车还在不在动。²
3. 断线时两个执行器故意反着做：舵机冻结，电机归零。²

适用于桌面台架S32K144 + STM32G474500 kbps Classic CAN10 ms 周期

1

## 一次换挡，信号走了哪几段？

两颗 MCU 各管一段：左边采集与决策，右边执行与反馈。³

两颗 ECU 之间的一条总线打开交互图

图的结构

- S32K144 s32k
- CAN 0x180 bus
- G474 g474
- s32k → bus · 目标挡 + 车速
- bus → g474 · 8 字节

0x180 每 10 ms 发一帧，0x280 把实际挡位和舵机角度送回来。⁴

2

## 出 P 挡，要同时满足什么？

上电默认 P。四条同时成立，再推一次摇杆，才换到 D 或 R。¹

条件 | 门槛 | 不满足时屏幕显示
解锁键 | 按下 | NEED UNLOCK
刹车 | 大于 30% | NEED BRAKE
车速 | 低于 5 km/h | STOP FIRST
摇杆 | 回中后前推 | PUSH FWD

摇杆要先回中、再推过去，按住不放不会连续换挡。

### N/D/R 之间不用解锁

解锁键是整台车的总闸。进入 D 之后，挡间切换只看车速和摇杆方向，和真车一致。

3

## 断线了，为什么舵机不动、电机却停？

两个执行器对失联给出相反动作，因为错误动作的代价不同。²

对象 | 谁判 | 时限 | 动作
舵机 | G474 | 0.5 s | 冻结在最后角度
电机 | G474 | 0.5 s | 200 ms 斜坡归零，锁存
决策 | S32K | 2 s | 进 FAULT，发 255

行驶中把 D 拉回 P，可能打坏换挡机构；动力没人管，车会自己冲出去。所以舵机保持、电机归零。

### EXEC LOCK：怕对端刚重启

行驶中 S32K 复位，G474 会拒绝 P/R 直到整板断电。它比对车速跳变和计数连续性，判断对面是不是换了个人。²

4

## 面试时怎么演示？

四个动作，两分半，每个盯一个失败模式。⁵

时间 | 操作 | 该看到
0:00 · 40 s | 刹车、解锁、前推 | P 变 D，舵机转到 108°
0:40 · 30 s | 不按解锁直接推 | 不动，屏幕 NEED UNLOCK
1:10 · 50 s | 拔掉 CAN 线 | 2 s 后 FAULT，舵机不动
2:00 · 30 s | 行驶中复位 S32K | P/R 被拒，屏幕 EXEC LOCK

屏幕会自己提示缺哪一步，互锁几乎不用讲。

### 已知边界

舵机没有位置反馈，S32K 看门狗尚未使能，报文没有 E2E，Classic CAN 未升 FD。台架够用，量产还差一层。⁶

## 来源

1. 手册 07：换挡状态机与互锁Shift-by-Wire_手册/07_换挡状态机与互锁.md
2. 手册 06：执行侧，舵机与 CANShift-by-Wire_手册/06_执行侧_舵机与CAN.md
3. 项目 README：架构与安全策略README.md
4. 手册 05：CAN 通信协议Shift-by-Wire_手册/05_CAN通信协议.md
5. 手册 10：HMI 与演示脚本Shift-by-Wire_手册/10_HMI界面与演示脚本.md
6. 手册 11：14 个调试坑Shift-by-Wire_手册/11_调试踩坑记录.md

Archify把你想理解、规划或分享的事，变成可以互动的可视化作品。 (https://github.com/tt-a1i/archify)

4 个面板1 张图已通过结构校验6 个来源

关闭Esc

正在打开交互图…

'); frame.srcdoc = end < 0 ? html + script : html.slice(0,end) + script + html.slice(end); },()=>notify(say('This diagram could not be opened.','无法打开此交互图。'))); } // The page stores each native Viewer gzip-compressed; inflate it once, on first open. function nativeHtml(diagram) { if (typeof diagram.html === 'string') return Promise.resolve(diagram.html); const bytes = Uint8Array.from(atob(diagram.htmlGzip),character=>character.charCodeAt(0)); return diagram.inflating ||= new Response(new Blob([bytes]).stream().pipeThrough(new DecompressionStream('gzip'))).text(); } function closeViewer() { if(viewerDialog.open) viewerDialog.close(); } document.querySelector('[data-close-diagram]').addEventListener('click',closeViewer); viewerDialog.addEventListener('close',()=>{ document.body.classList.remove('dialog-open'); viewerOpener?.focus({preventScroll:true}); }); window.addEventListener('message',event=>{ if(!viewer || event.source !== viewer.frame.contentWindow || event.data?.token !== viewer.token) return; if(event.data.kind === 'archify-explainer-ready') {viewer.ready = true; viewerDialog.dataset.nativeReady = 'true'; viewerDialog.querySelector('.dialog-loading').hidden = true; sendViewer();} else if(event.data.kind === 'archify-explainer-focus-result') {viewerDialog.dataset.nativeFocus = JSON.stringify({nodes:event.data.nodes,edges:event.data.edges,active:event.data.active});} else if(event.data.kind === 'archify-explainer-escape') closeViewer(); }); all('[data-open-diagram]').forEach(button=>button.addEventListener('click',()=>openViewer(button.dataset.openDiagram,'',button))); // A node clicked in the preview opens the interactive view focused on it, with its links. all('.diagram-preview').forEach(preview=>preview.addEventListener('click',event=>{ const node = event.target.closest('[data-node-id]')?.dataset.nodeId, block = preview.closest('.block'); if (node) openViewer(block.id,`focus=${encodeURIComponent(node)}`,block.querySelector('[data-open-diagram]')); })); // One spotlight for every text-to-diagram link: the named nodes and edges stay lit, the rest dims. const previewOf = id => byId(id)?.querySelector('.diagram-preview'); function spotlight(preview, nodes = [], edges = []) { if (!preview) return; let matched = false; all('[data-node-id],[data-edge-id]',preview).forEach(element=>{const hit = nodes.includes(element.dataset.nodeId) || edges.includes(element.dataset.edgeId); matched ||= hit; element.classList.toggle('reader-highlight',hit);}); preview.classList.toggle('focusing',matched); } const targetOf = link => { const hash = link.dataset.diagramHash || ''; let edges = []; try { edges = JSON.parse(link.dataset.diagramEdges || '[]'); } catch {} return {preview:previewOf(link.dataset.diagramLink),nodes:hash.startsWith('focus=') ? [decodeURIComponent(hash.slice(6))] : hash.startsWith('route=') ? hash.slice(6).split('~').map(decodeURIComponent) : [],edges}; }; all('[data-diagram-link]').forEach(link=>{ link.addEventListener('click',event=>{ event.preventDefault(); openViewer(link.dataset.diagramLink,link.dataset.diagramHash || '',link); }); // A walk-through owns the highlight while it runs. const highlight = active => { if (walking) return; const {preview,nodes,edges} = targetOf(link); spotlight(preview,active ? nodes : [],active ? edges : []); }; // A step lights its part of the diagram from anywhere in it, its description included. const hover = link.closest('.steps>li') || link; hover.addEventListener('mouseenter',()=>highlight(true)); hover.addEventListener('mouseleave',()=>highlight(false)); link.addEventListener('focus',()=>highlight(true)); link.addEventListener('blur',()=>highlight(false)); }); // A name in the text that is also a node label is linked to that node, once per panel, both ways: // hovering the word lights the node, hovering the node lights the word. function linkTerms() { const terms = new Map(); all('.diagram-preview').forEach(preview=>all('[data-node-id][data-node-label]',preview).forEach(node=>{ const label = node.dataset.nodeLabel.trim(); const target = {diagram:preview.closest('.block').id,node:node.dataset.nodeId}; if ((/\p{Script=Han}/u.test(label) ? label.length >= 2 : label.length >= 3) && !terms.has(label.toLowerCase())) terms.set(label.toLowerCase(),target); // A plain-word ID ("server" for "Server :443") also names the node in English prose. if (/^[a-z]{3,}$/.test(target.node) && !terms.has(target.node)) terms.set(target.node,target); })); if (!terms.size) return; const pattern = new RegExp([...terms.keys()].sort((a,b)=>b.length - a.length).map(label=>label.replace(/[.*+?^${}()|[\]\\]/g,'\\$&')) .join('|'),'giu'); const word = /[\p{L}\p{N}_]/u; all('.panel').forEach(panel=>{ const seen = new Set(); const walker = document.createTreeWalker(panel.querySelector('.panel-body') || panel,NodeFilter.SHOW_TEXT,{acceptNode:text=>text.parentElement.closest('.block-diagram,.block-chart,pre,code,a,button,svg,figcaption,.term,.diagram-semantics,thead') ? NodeFilter.FILTER_REJECT : NodeFilter.FILTER_ACCEPT}); const texts = []; while (walker.nextNode()) texts.push(walker.currentNode); for (const text of texts) { const value = text.nodeValue, parts = []; let last = 0; for (const match of value.matchAll(pattern)) { const before = value[match.index - 1], after = value[match.index + match[0].length]; if (seen.has(match[0].toLowerCase()) || (!/\p{Script=Han}/u.test(match[0]) && ((before && word.test(before)) || (after && word.test(after))))) continue; seen.add(match[0].toLowerCase()); parts.push(value.slice(last,match.index),match[0]); last = match.index + match[0].length; } if (!parts.length) continue; const fragment = document.createDocumentFragment(); parts.forEach((part,index)=>{ if (index % 2 === 0) { fragment.append(part); return; } const target = terms.get(part.toLowerCase()), span = document.createElement('span'); span.className = 'term'; span.dataset.diagram = target.diagram; span.dataset.node = target.node; span.textContent = part; fragment.append(span); }); fragment.append(value.slice(last)); text.replaceWith(fragment); } }); all('.term').forEach(term=>{ const lit = on => spotlight(previewOf(term.dataset.diagram),on ? [term.dataset.node] : []); term.addEventListener('mouseenter',()=>lit(true)); term.addEventListener('mouseleave',()=>lit(false)); }); all('.diagram-preview').forEach(preview=>{ const id = preview.closest('.block').id; preview.addEventListener('mouseover',event=>{ const node = event.target.closest('[data-node-id]')?.dataset.nodeId; all('.term').forEach(term=>term.classList.toggle('term-lit',term.dataset.diagram === id && term.dataset.node === node)); }); preview.addEventListener('mouseleave',()=>all('.term-lit').forEach(term=>term.classList.remove('term-lit'))); }); } // Walk-through: step lists that point into a diagram, and sequence diagrams message by message. // Each step lights its part of the diagram; arrow keys move, Escape ends. let walking = null; function walk(control, items, show) { const stop = () => { walking?.end(); }; if (walking?.control === control) { stop(); return; } stop(); let index = 0; const bar = document.createElement('div'); bar.className = 'walk-bar'; bar.innerHTML = `← ${words.prev}${words.next} →${words.end}`; // A diagram's bar sits above the diagram, so it stays in view while a tall diagram scrolls past. const figure = control.closest('figcaption')?.closest('figure'); if (figure) figure.before(bar); else control.after(bar); // The bar takes the start button's place while the walk runs, so one set of controls shows. const hadFocus = document.activeElement === control; control.setAttribute('aria-pressed','true'); control.hidden = true; if (hadFocus) bar.querySelector('[data-walk=next]').focus(); // The bar changes the panel height the board was planned with. const replan = () => requestAnimationFrame(()=>{ layoutBoard(); ensureDiagramReadability(); }); replan(); const render = () => { bar.querySelector('.walk-count').textContent = `${index + 1} / ${items.length}`; bar.querySelector('.walk-text').textContent = show(index) || ''; }; const move = delta => { index = Math.max(0,Math.min(items.length - 1,index + delta)); render(); }; bar.addEventListener('click',event=>{ const action = event.target.closest('[data-walk]')?.dataset.walk; if (action === 'end') stop(); else if (action) move(action === 'next' ? 1 : -1); }); const keys = event => { if (event.target.closest('input,textarea') || viewerDialog.open) return; if (event.key === 'ArrowRight') { event.preventDefault(); move(1); } else if (event.key === 'ArrowLeft') { event.preventDefault(); move(-1); } else if (event.key === 'Escape') stop(); }; document.addEventListener('keydown',keys); walking = {control,end:()=>{ const refocus = bar.contains(document.activeElement); document.removeEventListener('keydown',keys); bar.remove(); control.hidden = false; control.setAttribute('aria-pressed','false'); if (refocus) control.focus(); show(-1); walking = null; replan(); }}; render(); } function setupWalks() { all('ol.steps').forEach(list=>{ const steps = all(':scope>li',list).filter(item=>item.querySelector('[data-diagram-link]')); if (steps.length < 2) return; const button = document.createElement('button'); button.type = 'button'; button.className = 'walk-start interactive'; button.textContent = `▶ ${words.walk}`; button.setAttribute('aria-pressed','false'); list.before(button); button.addEventListener('click',()=>walk(button,steps,index=>{ steps.forEach((step,i)=>step.classList.toggle('walk-current',i === index)); all('.diagram-preview').forEach(preview=>spotlight(preview)); if (index < 0) return; const {preview,nodes,edges} = targetOf(steps[index].querySelector('[data-diagram-link]')); spotlight(preview,nodes,edges); const box = preview?.getBoundingClientRect(); if (box && (box.bottom < 0 || box.top > innerHeight)) preview.scrollIntoView({block:'nearest',behavior:'smooth'}); })); }); // A workflow no step list walks through can be walked node by node, in the order it was written, // each node lit with the edges that lead into it. const walked = new Set(all('ol.steps [data-diagram-link]').map(link=>link.dataset.diagramLink)); all('.block-diagram').forEach(block=>{ const diagram = diagrams[block.id], nodes = diagram?.semantic?.nodes || [], edges = diagram?.semantic?.edges || []; if (diagram?.diagramType !== 'workflow' || walked.has(block.id) || nodes.length < 3) return; const preview = block.querySelector('.diagram-preview'); const button = document.createElement('button'); button.type = 'button'; button.className = 'walk-start'; button.textContent = `▶ ${words.walkFlow}`; button.setAttribute('aria-pressed','false'); block.querySelector('.diagram-title')?.after(button); button.addEventListener('click',()=>walk(button,nodes,index=>{ if (index < 0) { spotlight(preview); return; } const node = nodes[index], into = edges.filter(edge=>edge.to === node.id && (index === 0 || nodes.slice(0,index).some(seen=>seen.id === edge.from))); spotlight(preview,[node.id,...into.map(edge=>edge.from)],into.map(edge=>edge.id)); const target = preview.querySelector(`[data-node-id="${CSS.escape(node.id)}"]`), box = target?.getBoundingClientRect(); if (box && (box.top < 0 || box.bottom > innerHeight - 80)) target.scrollIntoView({block:'center',behavior:'smooth'}); return node.label || node.id; })); }); all('.block-diagram').forEach(block=>{ if (diagrams[block.id]?.diagramType !== 'sequence') return; const preview = block.querySelector('.diagram-preview'), messages = all('[data-edge-id]',preview); if (messages.length < 2) return; const button = document.createElement('button'); button.type = 'button'; button.className = 'walk-start'; button.textContent = `▶ ${words.walkMessages}`; button.setAttribute('aria-pressed','false'); block.querySelector('.diagram-title')?.after(button); const label = id => preview.querySelector(`[data-node-id="${CSS.escape(id)}"]`)?.dataset.nodeLabel || id; button.addEventListener('click',()=>walk(button,messages,index=>{ if (index < 0) { spotlight(preview); return; } const message = messages[index]; spotlight(preview,[message.dataset.edgeFrom,message.dataset.edgeTo],[message.dataset.edgeId]); const box = message.getBoundingClientRect(); if (box.top < 0 || box.bottom > innerHeight - 80) message.scrollIntoView({block:'center',behavior:'smooth'}); return `${label(message.dataset.edgeFrom)} → ${label(message.dataset.edgeTo)}${say(': ','：')}${message.dataset.edgeLabel || ''}`; })); }); } all('[data-copy]').forEach(button=>button.addEventListener('click',()=>{ const text = button.closest('figure').querySelector('pre code').textContent; Promise.resolve(navigator.clipboard?.writeText(text)).then(()=>{button.textContent = words.copied;setTimeout(()=>{button.textContent = words.copy;},1600);},()=>notify(say('Copy failed.','复制失败。'))); })); // Follow-up questions: a reader asks about a panel, or about selected text in it, and copies a // message that names the page, the panel ID and the quote, so the agent can revise just that panel. function setupAsk() { const dialog = document.createElement('dialog'); dialog.className = 'ask-dialog'; const mac = /Mac|iPhone|iPad/.test(navigator.platform || navigator.userAgent); dialog.innerHTML = `

## ${words.ask}

${words.askChips.map(chip=>`${chip}`).join('')}

${words.askNote}

${words.askCancel}${words.askCopy}${mac ? '⌘↵' : 'Ctrl ↵'}

`; document.body.append(dialog); const area = dialog.querySelector('textarea'), quoteBox = dialog.querySelector('blockquote'); let context = null; const open = (panel, quote = '') => { const number = panel.id === 'answer' ? words.answer : panel.querySelector('.panel-id')?.textContent.trim(); const title = panel.id === 'answer' ? words.answer : panel.dataset.title || panel.querySelector('h2')?.textContent.trim(); context = {panel,quote,number,title}; dialog.querySelector('.ask-where').textContent = panel.id === 'answer' ? title : say(`Panel ${number} · ${title}`,`面板 ${number} · ${title}`); all('[data-chip]',dialog).forEach(chip=>chip.setAttribute('aria-pressed','false')); quoteBox.hidden = !quote; quoteBox.textContent = quote; area.value = ''; dialog.showModal(); area.focus(); }; // A suggested question is added once; choosing it again takes it back out. dialog.querySelectorAll('[data-chip]').forEach(chip=>chip.addEventListener('click',()=>{ const lines = area.value.split('\n').filter(line=>line.trim()), on = !lines.includes(chip.textContent); area.value = (on ? [...lines,chip.textContent] : lines.filter(line=>line !== chip.textContent)).join('\n'); chip.setAttribute('aria-pressed',String(on)); area.focus(); })); area.addEventListener('keydown',event=>{ if (event.key === 'Enter' && (event.metaKey || event.ctrlKey)) { event.preventDefault(); dialog.querySelector('form').requestSubmit(); } }); dialog.querySelectorAll('[data-ask-cancel]').forEach(button=>button.addEventListener('click',()=>dialog.close())); dialog.querySelector('form').addEventListener('submit',event=>{ event.preventDefault(); const {panel,quote,number,title} = context, page = document.querySelector('h1')?.textContent.trim(); const file = location.protocol === 'file:' ? decodeURIComponent(location.pathname) : location.href.split('#')[0]; const quoteMark = text => english ? `"${text}"` : `「${text}」`; const lines = [ `${words.askPage}${say(': ','：')}${quoteMark(page)}`, `${words.askFile}${say(': ','：')}${file}`, `${words.askWhere}${say(': ','：')}${panel.id === 'answer' ? title : say(`Panel ${number} ${quoteMark(title)}`,`面板 ${number}${quoteMark(title)}`)}${say(` (ID: ${panel.id})`,`（ID: ${panel.id}）`)}`, ...(quote ? [`${words.askQuoteLabel}${say(': ','：')}${quoteMark(quote)}`] : []), `${words.askQuestion}${say(': ','：')}${area.value.trim() || words.askChips[0]}`, ...(panel.id === 'answer' ? [] : [words.askPatch]), ]; const text = lines.join('\n'); Promise.resolve(navigator.clipboard?.writeText(text)).then(()=>{ dialog.close(); notify(words.askCopied); },()=>{ area.value = text; area.select(); }); }); all('.panel').forEach(panel=>{ const button = document.createElement('button'); button.type = 'button'; button.className = 'ask-button interactive'; button.textContent = words.ask; button.addEventListener('click',()=>open(panel)); panel.querySelector('.panel-head')?.append(button); }); const floating = document.createElement('button'); floating.type = 'button'; floating.className = 'ask-floating'; floating.textContent = words.askQuote; floating.hidden = true; document.body.append(floating); let selected = null; document.addEventListener('selectionchange',()=>{ const selection = getSelection(), text = selection.toString().replace(/\s+/g,' ').trim(); const panel = selection.rangeCount ? selection.getRangeAt(0).commonAncestorContainer.parentElement?.closest?.('.panel') || (selection.getRangeAt(0).commonAncestorContainer.closest?.('.panel')) : null; if (!panel || text.length < 2 || dialog.open) { floating.hidden = true; selected = null; return; } const box = selection.getRangeAt(0).getBoundingClientRect(); selected = {panel,text:text.slice(0,400)}; floating.style.left = `${Math.max(8,Math.min(innerWidth - 120,box.left + box.width / 2 - 45 + scrollX))}px`; floating.style.top = `${box.top + scrollY - 38}px`; floating.hidden = false; }); floating.addEventListener('mousedown',event=>event.preventDefault()); floating.addEventListener('click',()=>{ if (selected) open(selected.panel,selected.text); floating.hidden = true; }); } // Source cards: hovering or focusing a citation shows where the claim comes from, with the pinned // code excerpt for a repository source, so a reader can check it without leaving the page. const glyph = path => ``; const sourceIcons = { code:glyph('M5.5 5 2.5 8l3 3M10.5 5l3 3-3 3M9 3.5 7 12.5'), web:glyph('M8 2a6 6 0 1 0 0 12A6 6 0 0 0 8 2zM2 8h12M8 2c1.7 1.6 2.5 3.6 2.5 6S9.7 12.4 8 14C6.3 12.4 5.5 10.4 5.5 8S6.3 3.6 8 2z'), note:glyph('M4 2.5h5.5l2.5 2.5v8.5H4zM9.5 2.5V5H12M6 8h4M6 10.5h4'), }; function setupSourceCards() { const sources = prepared.preparedSources?.sources || {}; const card = document.createElement('div'); card.className = 'source-card'; card.hidden = true; card.setAttribute('role','tooltip'); document.body.append(card); let hideTimer; const hide = () => { hideTimer = setTimeout(()=>{ card.hidden = true; },160); }; card.addEventListener('mouseenter',()=>clearTimeout(hideTimer)); card.addEventListener('mouseleave',hide); const show = (link, id = decodeURIComponent(link.getAttribute('href').slice('#source-'.length))) => { const source = sources[id] || prepared.document?.sources?.find(entry=>entry.id === id); if (!source) return; clearTimeout(hideTimer); const escapeText = value => String(value ?? '').replace(/[&<>"]/g,character=>({'&':'&','<':'<','>':'>','"':'"'}[character])); // A repository source shows its pinned excerpt; a web page its host; any other note its text. const host = (()=>{ try { return new URL(source.url).host.replace(/^www\./,''); } catch { return ''; } })(); const where = source.path ? `${source.path}${source.lines ? `:${source.lines.join('–')}` : ''}` : host; const kind = source.path ? 'code' : source.url ? 'web' : 'note'; const lines = source.path && typeof source.text === 'string' ? source.text.split('\n') : []; const first = source.lines?.[0] || 1; const excerpt = lines.length ? `

${lines.slice(0,14).map((line,index)=>`${first + index}${escapeText(line) || ' '}`).join('')}${lines.length > 14 ? `…` : ''}

` : ''; const note = !source.path && (source.text || source.method) ? `

${escapeText(source.text || '')}${source.method ? `${escapeText(source.method)}` : ''}

` : ''; const number = /^\d+$/.test(link.textContent.trim()) ? link.textContent.trim() : ''; card.innerHTML = `

${sourceIcons[kind]}${escapeText(source.title || source.path || id)}${where ? `${escapeText(where)}` : ''}${number ? `${number}` : ''}

${excerpt}${note}${source.revision || source.url ? `

${source.revision ? `${say('Pinned at','固定在')} ${escapeText(String(source.revision).slice(0,7))}` : ''}${source.url ? `${say('Open source','打开原文')} ↗` : ''}

` : ''}`; card.hidden = false; const box = link.getBoundingClientRect(), width = Math.min(520,innerWidth - 24); card.style.width = `${width}px`; card.style.left = `${Math.max(12,Math.min(innerWidth - width - 12,box.left - 24)) + scrollX}px`; const below = box.bottom + 8 + card.offsetHeight < innerHeight; card.style.top = `${(below ? box.bottom + 8 : box.top - 8 - card.offsetHeight) + scrollY}px`; }; all('.cite a[href^="#source-"]').forEach(link=>{ link.addEventListener('mouseenter',()=>show(link)); link.addEventListener('focus',()=>show(link)); link.addEventListener('mouseleave',hide); link.addEventListener('blur',hide); }); // A diagram node tied to a source opens the same card, so a code diagram doubles as a code tour. all('.diagram-preview[data-node-sources]').forEach(preview=>{ let map = {}; try { map = JSON.parse(preview.dataset.nodeSources); } catch {} all('[data-node-id]',preview).forEach(node=>{ const id = map[node.dataset.nodeId]; if (!id) return; node.classList.add('has-source'); node.addEventListener('mouseenter',()=>show(node,id)); node.addEventListener('mouseleave',hide); }); }); document.addEventListener('keydown',event=>{ if (event.key === 'Escape') card.hidden = true; }); } // Checklist ticks are the reader's own progress; keep them per page and block across reloads. all('.checklist').forEach(list=>{ const key = `archify-checklist:${root.dataset.artifact}:${list.closest('.block').id}`, boxes = all('input',list); let saved = []; try { saved = JSON.parse(localStorage.getItem(key) || '[]'); } catch {} boxes.forEach((box,index)=>{ box.checked = saved[index] === 1; box.addEventListener('change',()=>{ try { localStorage.setItem(key,JSON.stringify(boxes.map(b=>b.checked ? 1 : 0))); } catch {} }); }); }); // Native dialogs supply Escape, focus trapping and the accessible modal semantics. const printDetails = new Map(); all('.diagram-semantics').forEach(details=>details.open = false); window.addEventListener('beforeprint',()=>all('.diagram-semantics').forEach(details=>{printDetails.set(details,details.open);details.open = true;})); window.addEventListener('afterprint',()=>{printDetails.forEach((open,details)=>details.open = open);printDetails.clear();}); root.classList.add('js'); applyTheme(); cropDiagramPreviews(); linkTerms(); setupWalks(); setupAsk(); setupSourceCards(); layoutBoard(); const relayout = () => { layoutBoard(); ensureDiagramReadability(); }; Promise.resolve(document.fonts?.ready).then(()=>requestAnimationFrame(()=>requestAnimationFrame(relayout))); let resizeFrame; window.addEventListener('resize',()=>{cancelAnimationFrame(resizeFrame);resizeFrame = requestAnimationFrame(relayout);}); })();
