koko-PhyuHtwe/electronic-shifter-mbd/S32K144/S32K144 EVB-REV2-Q100原理图.pdf

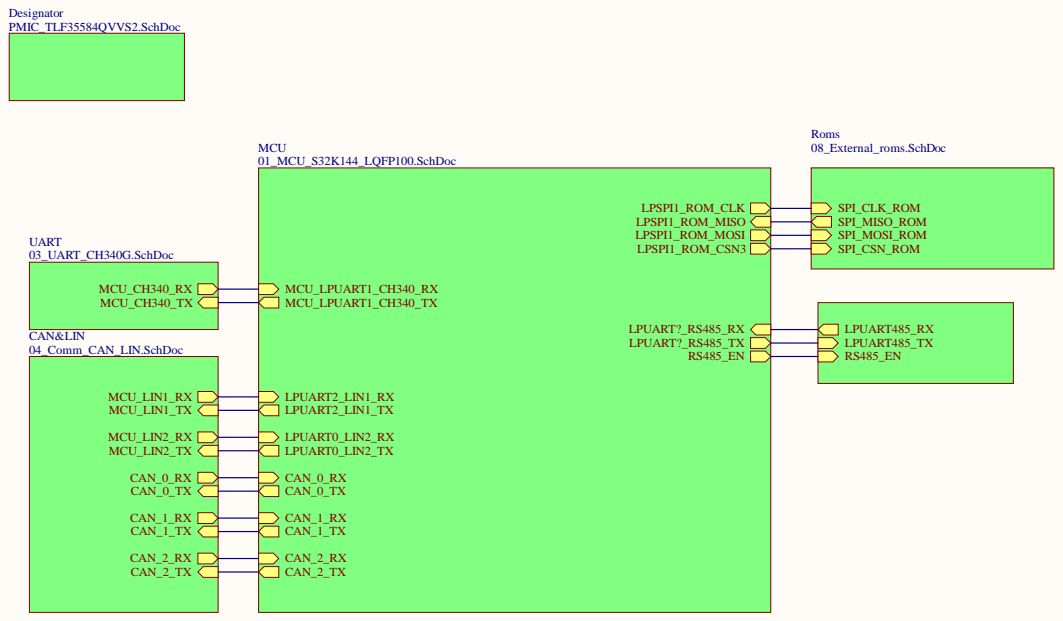
[picture p13: page 1]

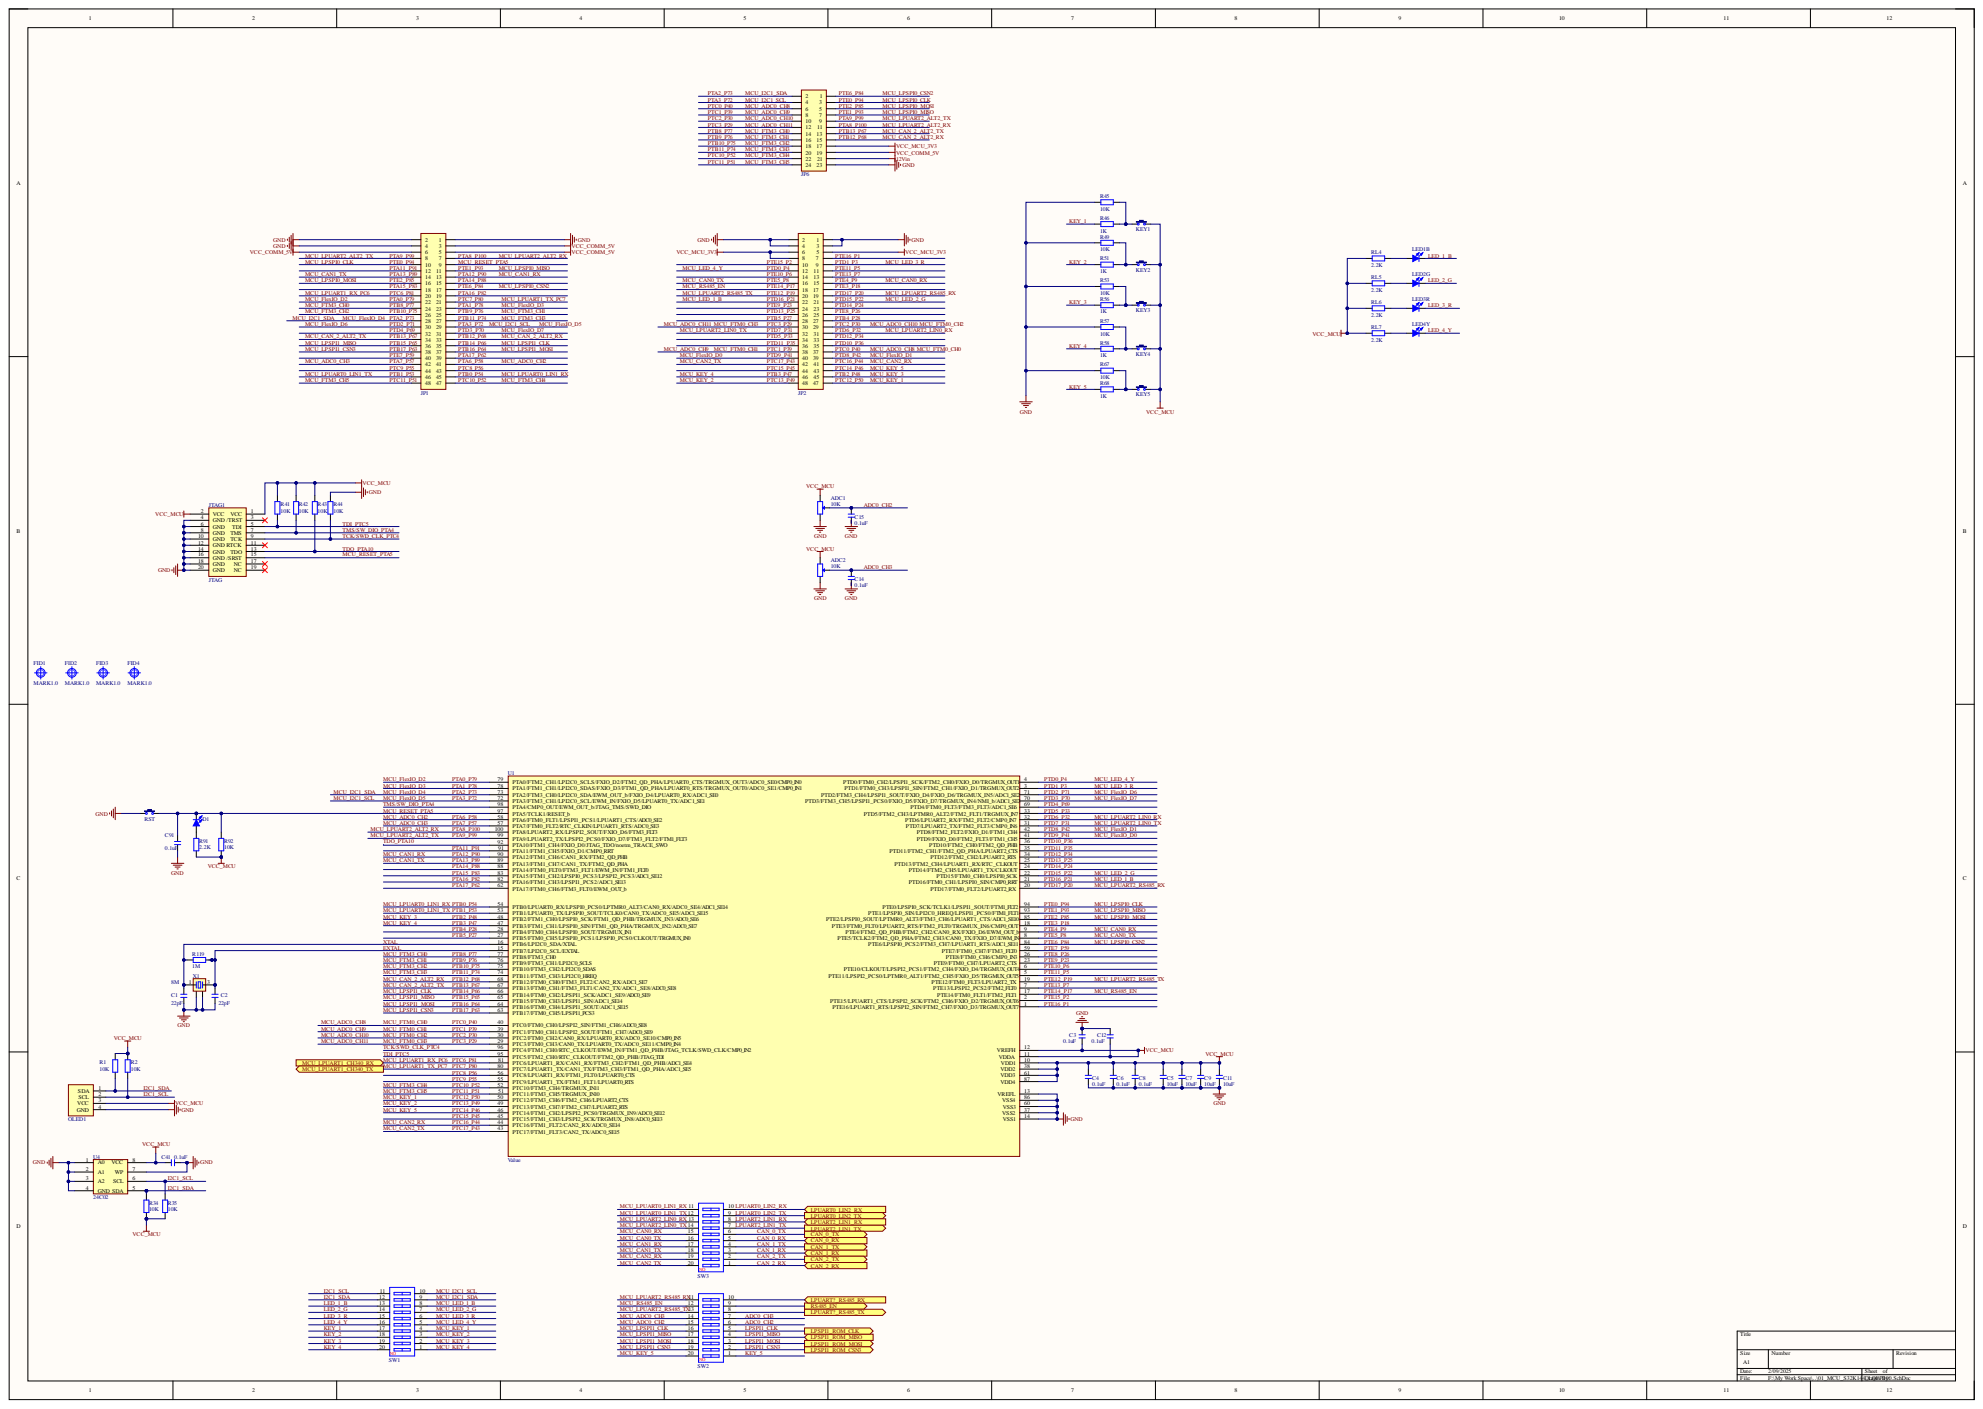
[picture p14: page 2]

MCU_ADC0_CH2 PTA6_P58 | PTA6/FTM0_FLT1/LPSPI1_PCS1/LPUART1_CTS/ADC0_SE2 58

MCU_FTM3_CH0 PTB8_P77 MCU_FTM3_CH1 PTB9_P76 | PTB8/FTM3_CH0 77 PTB9/FTM3_CH1/LPI2C0_SCLS 76

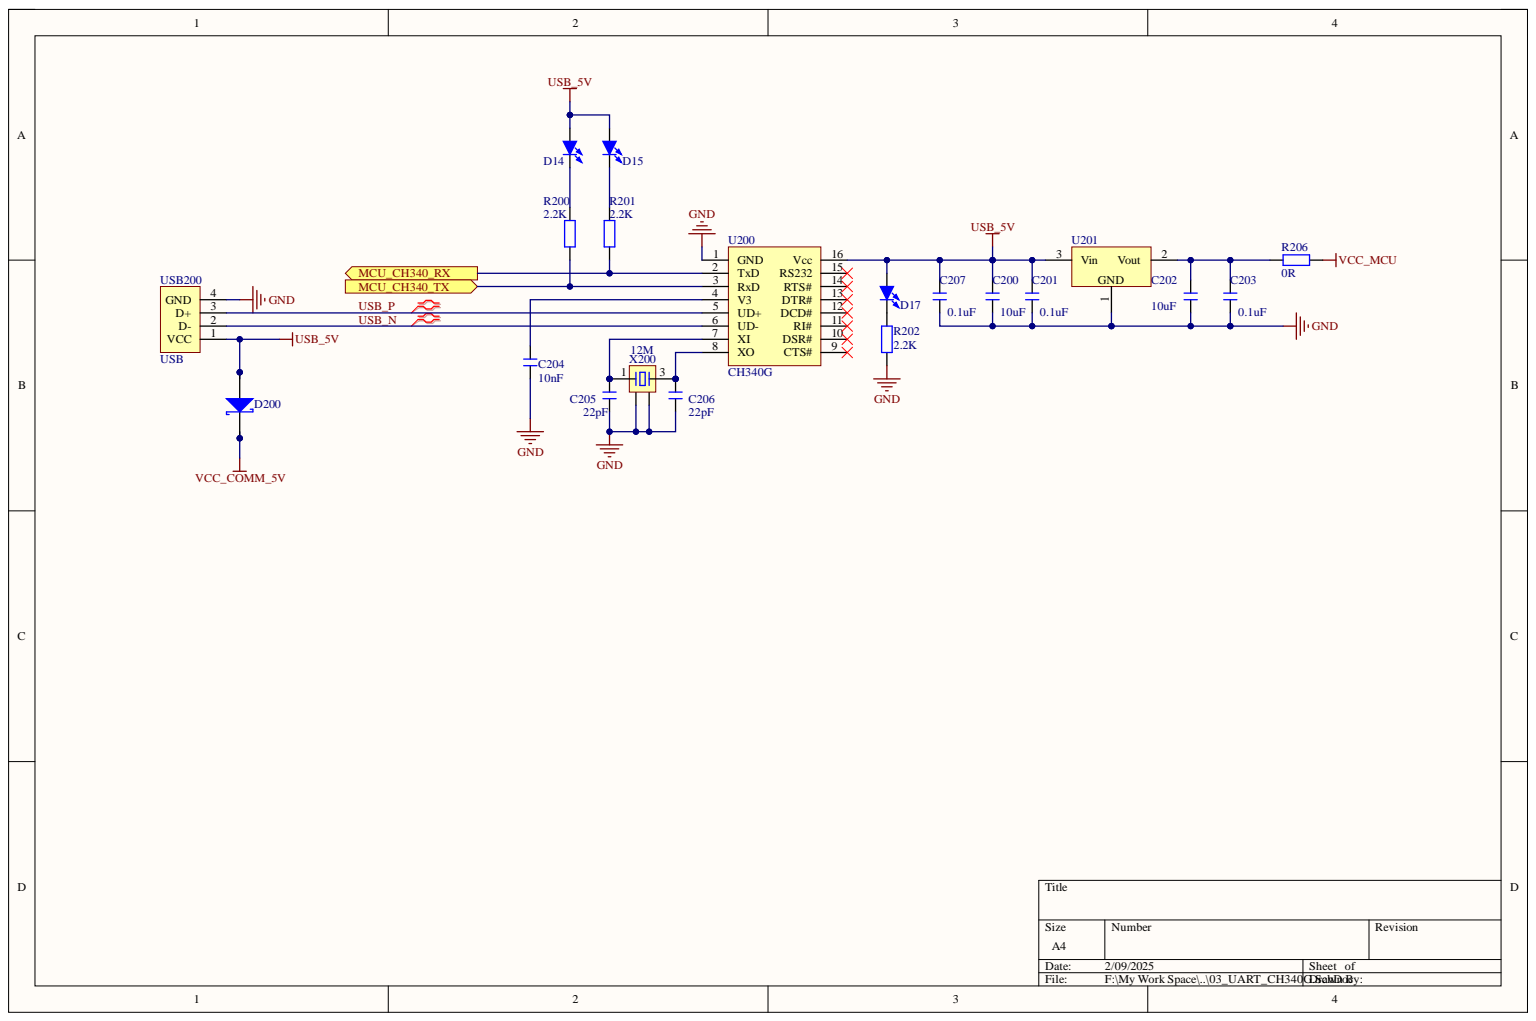
[picture p15: page 3]

2 USB_ N | 6

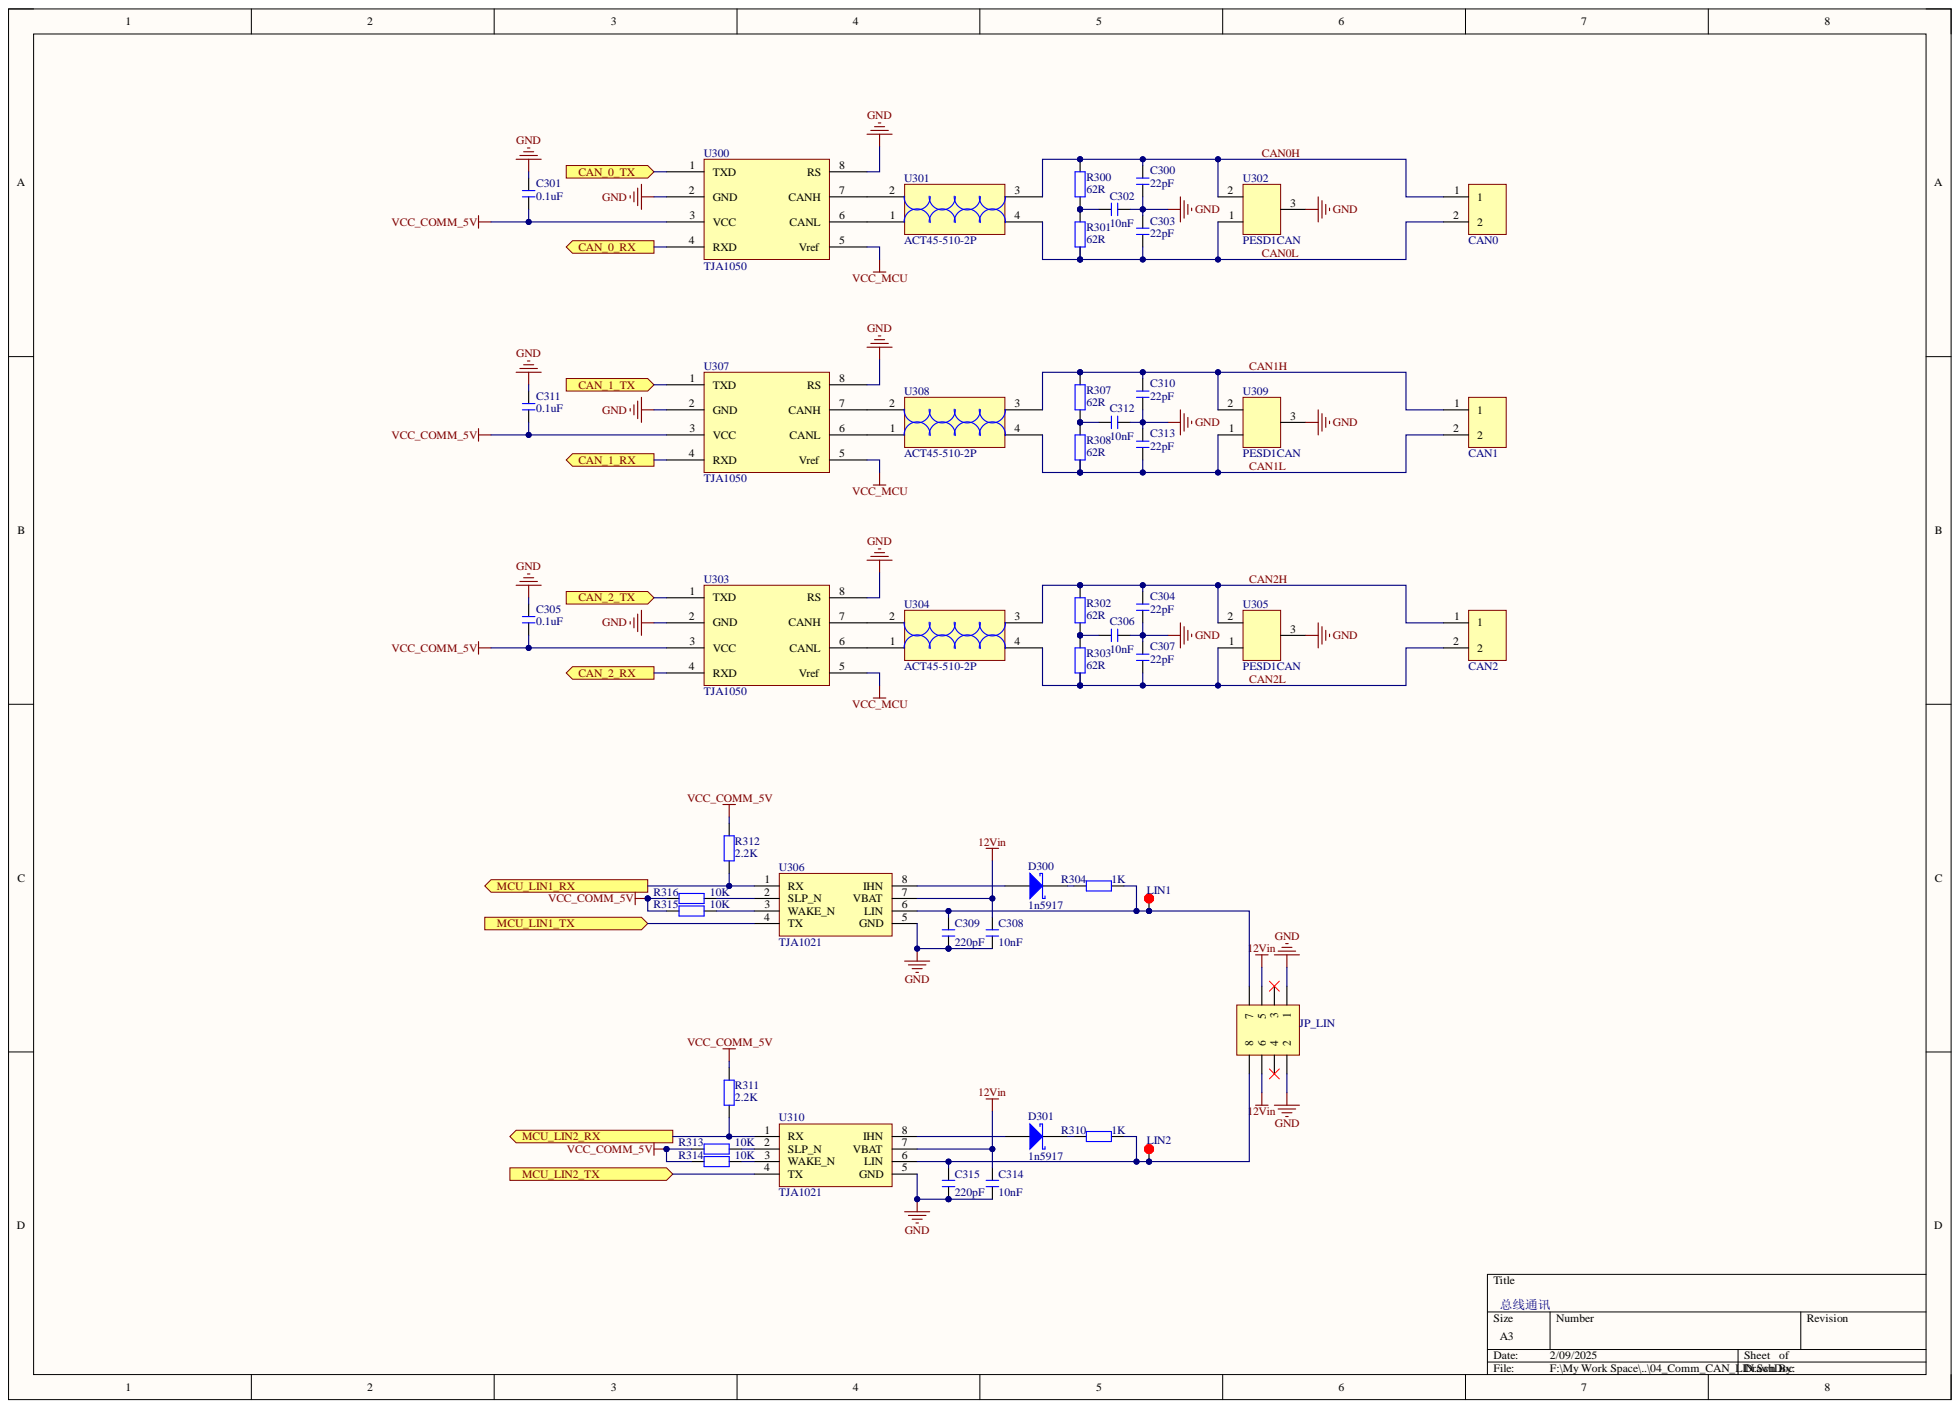
[picture p16: page 4]

SLP_N 2

R314 | 10K | WAKE_N 3

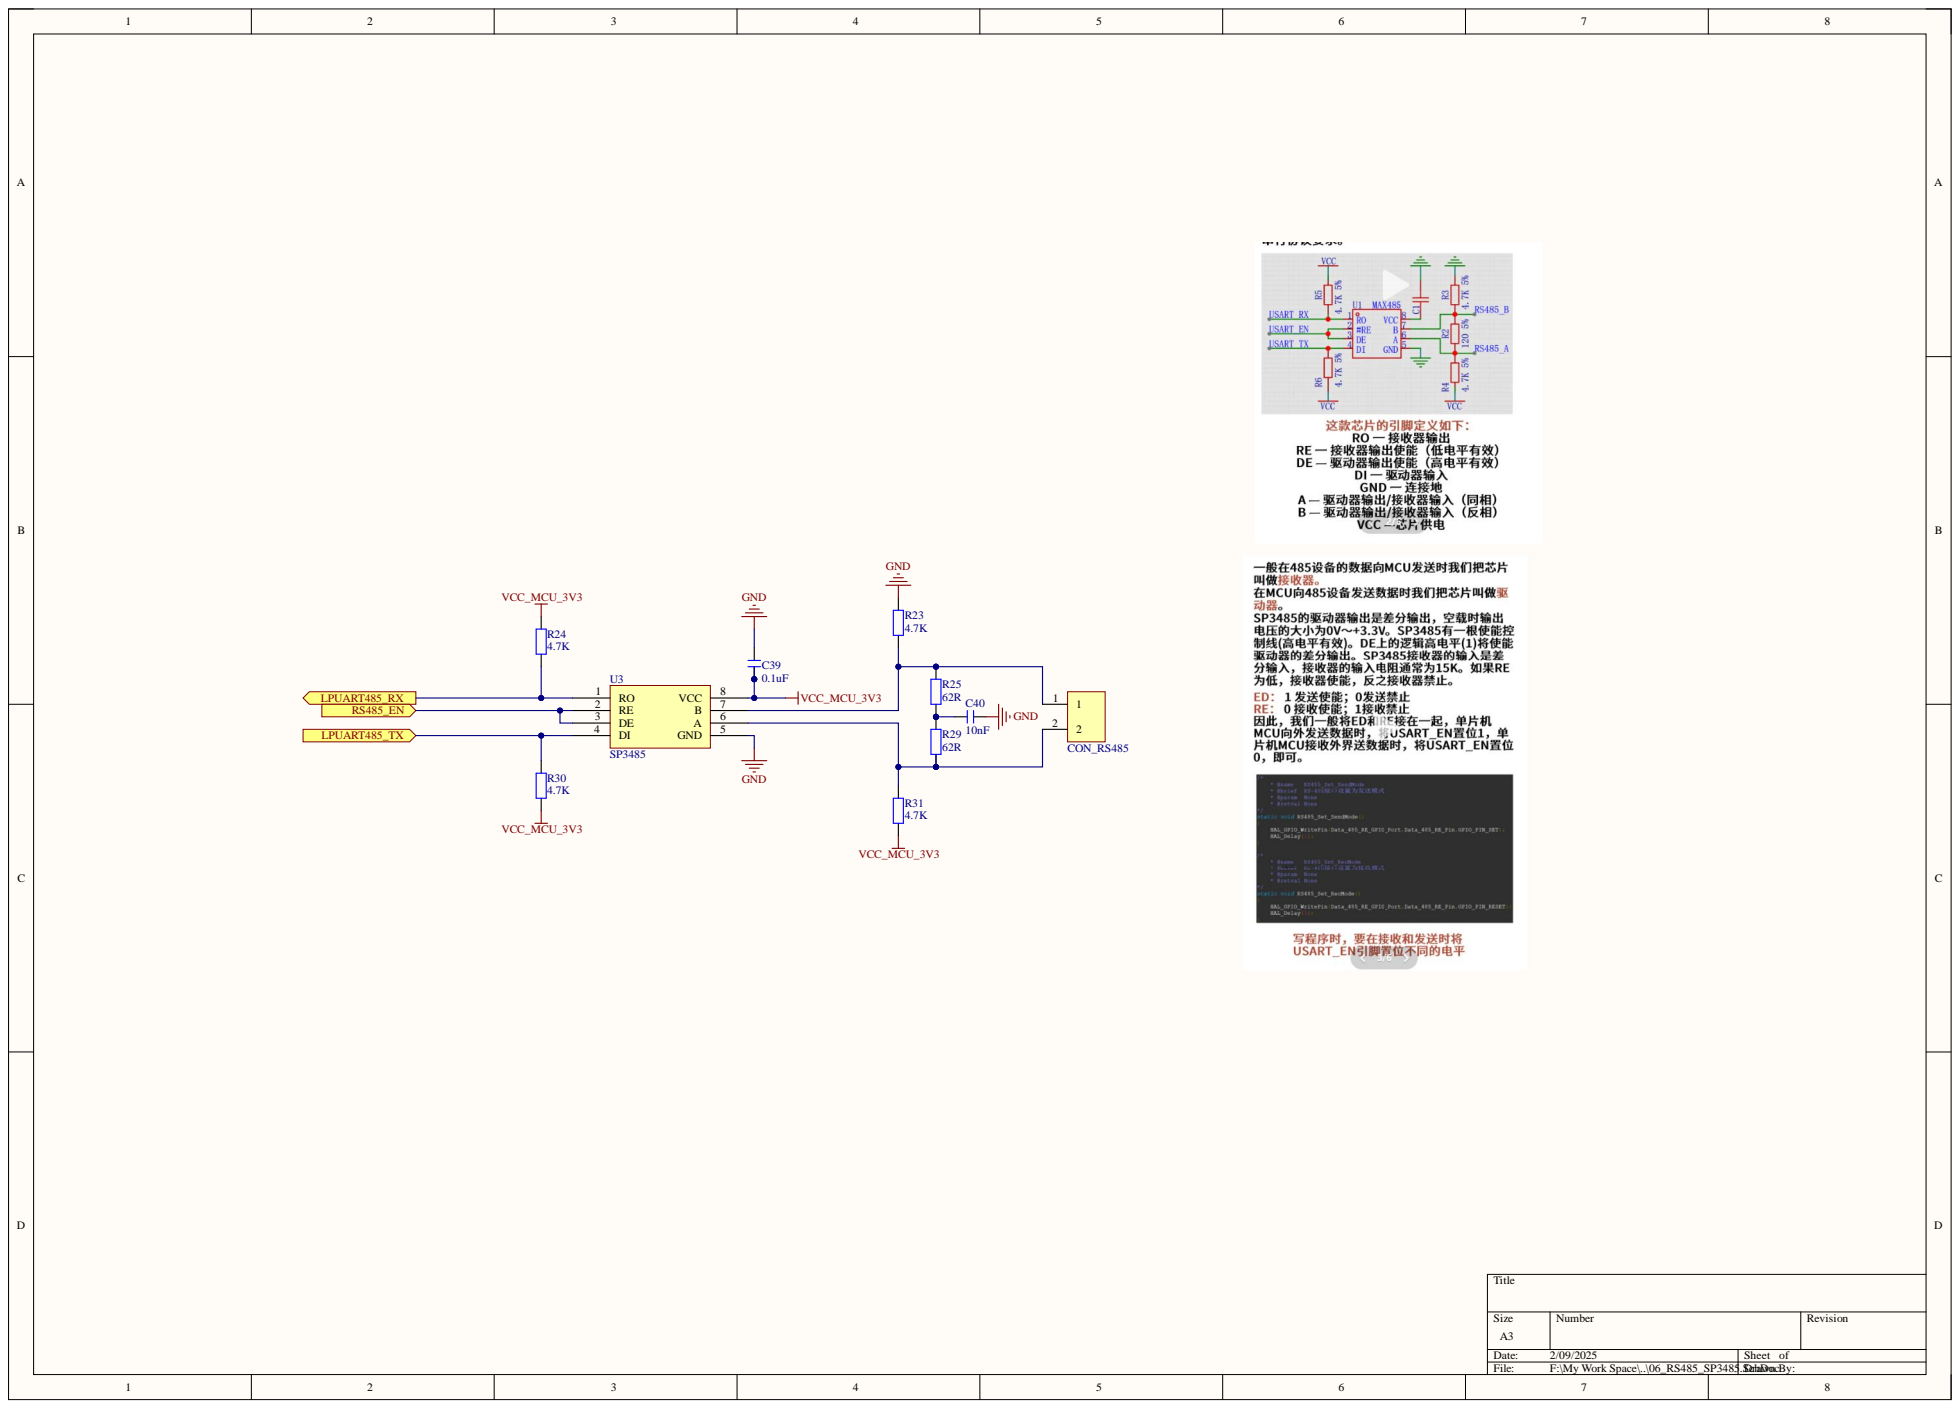
[picture p17: page 5]

Work Space\..\06_RS485_SP3485.SchD Drawocn By:

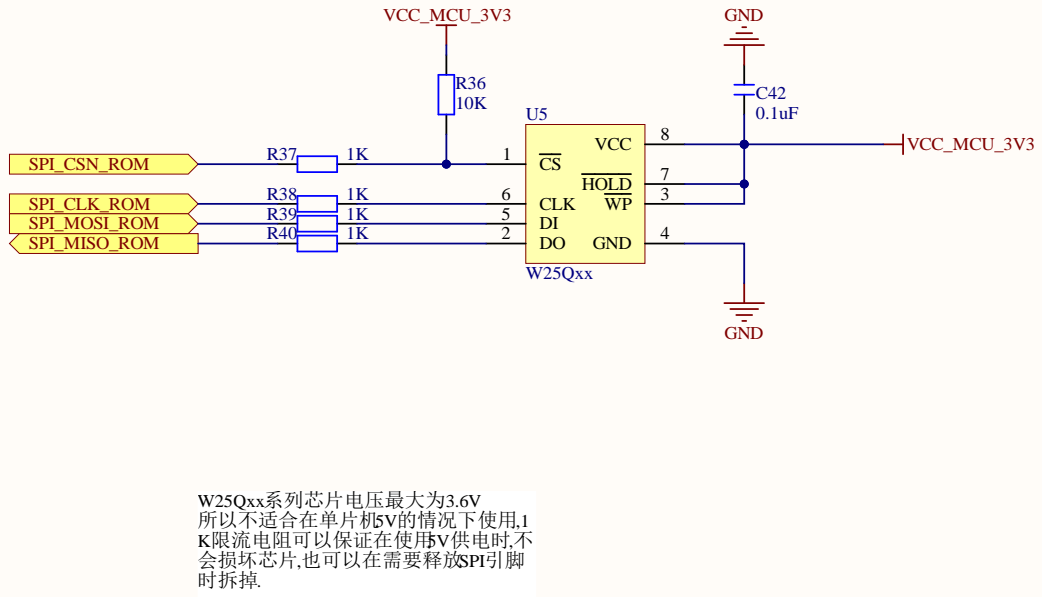
[picture p18: page 6]

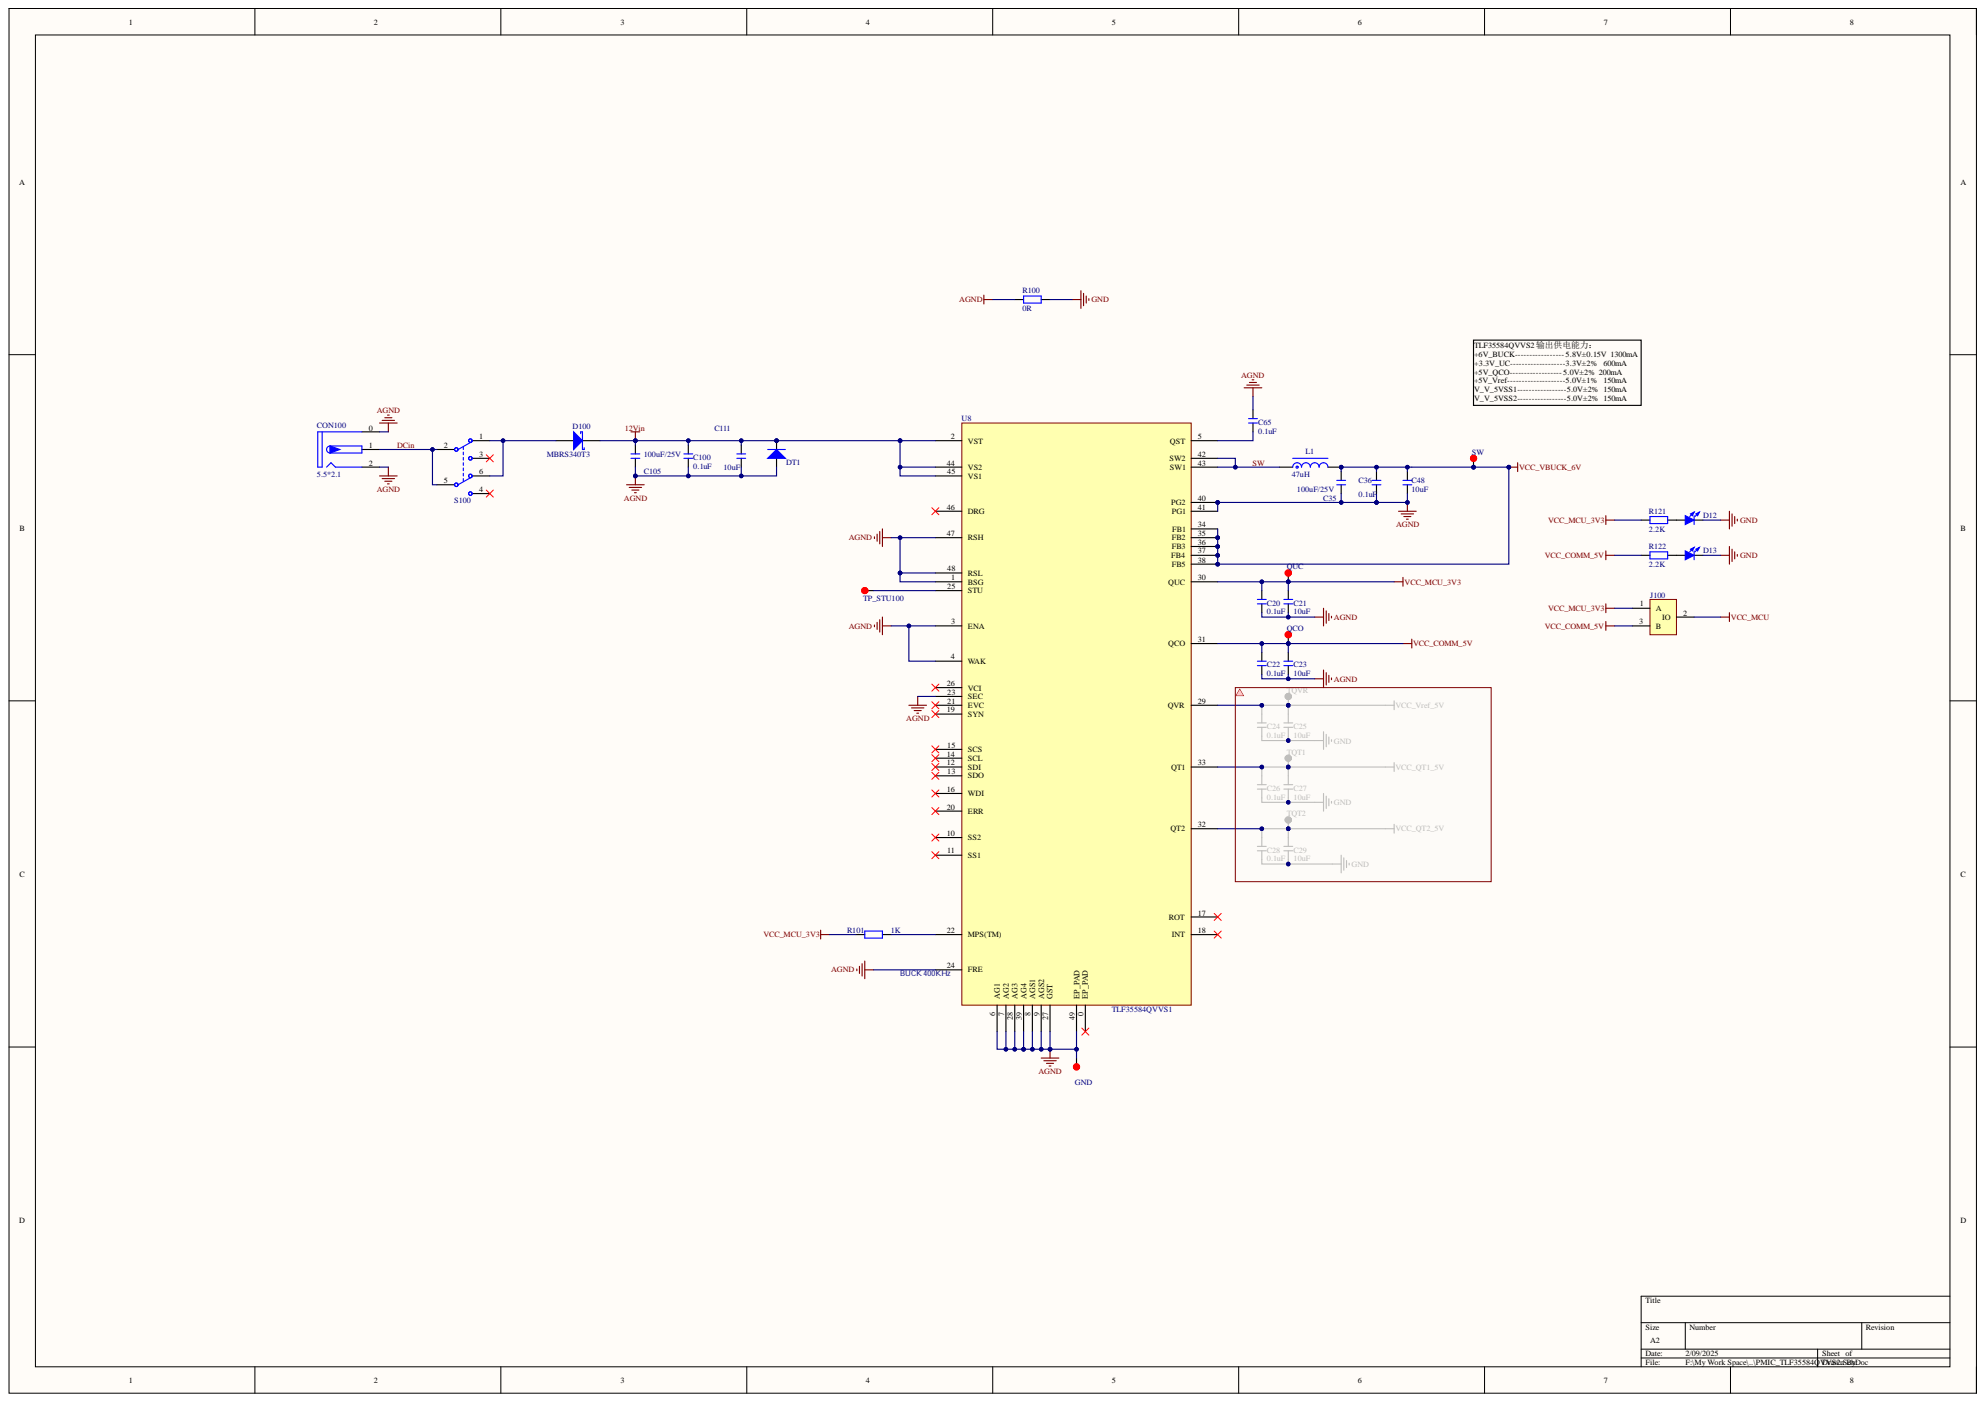
[picture p19: page 7]

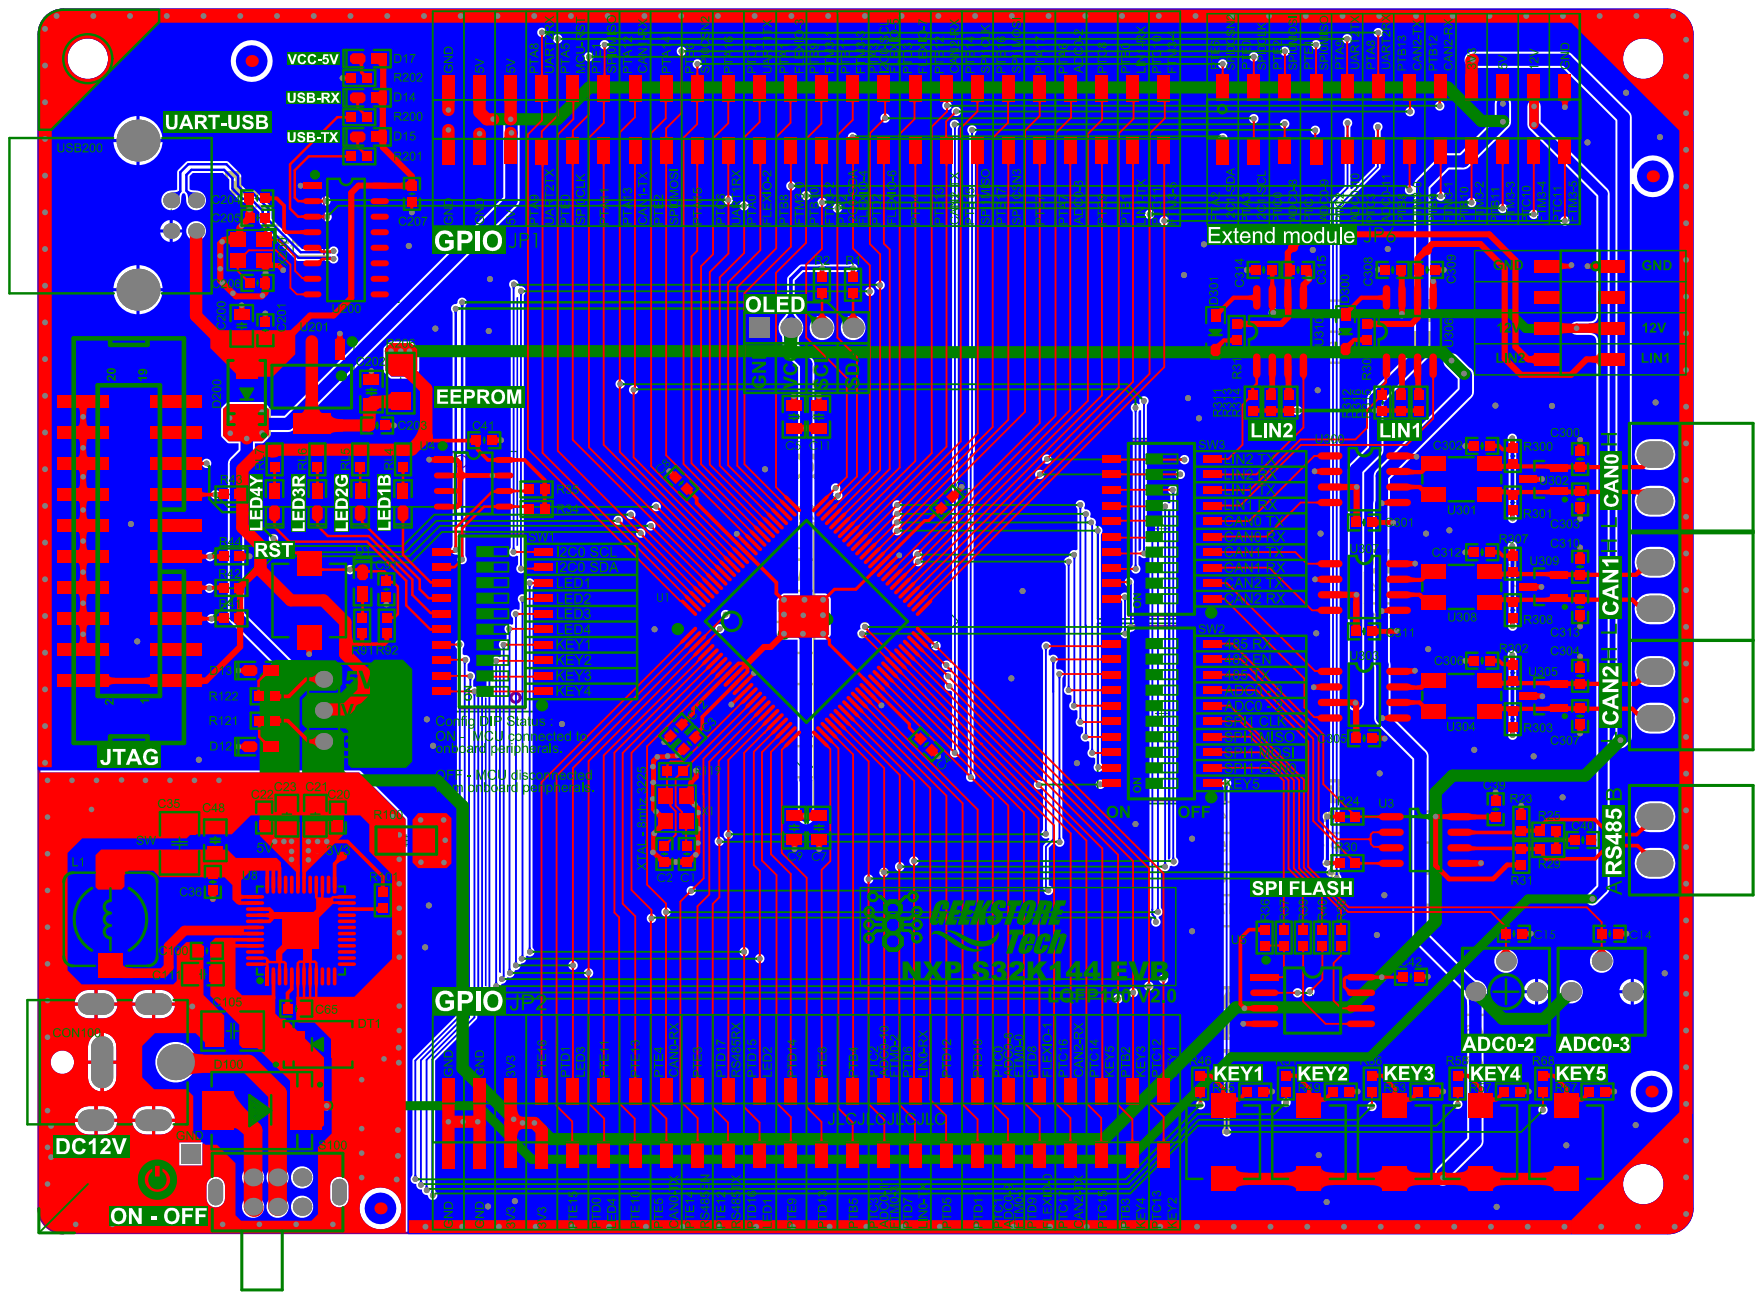
[picture p20: page 8]
