koko-PhyuHtwe/electronic-shifter-mbd/STM32G474VET6/ShiftByWire_HIL/Core/Src/main.c

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
/* Includes ------------------------------------------------------------------*/
#include "main.h"
#include "cmsis_os.h"
#include "adc.h"
#include "dma.h"
#include "fdcan.h"
#include "iwdg.h"
#include "tim.h"
#include "usart.h"
#include "gpio.h"


/* USER CODE BEGIN PV */
volatile uint8_t g_target_gear = 2;     /* default N */
volatile uint8_t g_actual_gear = 2;
volatile uint8_t g_servo_angle = 90;
volatile uint8_t g_status = 0;
volatile uint32_t g_can_rx_tick = 0;
volatile uint8_t  g_vehicle_speed = 0;   /* 来自 0x180 B4：车速 km/h */
volatile uint8_t  g_shift_inhibit = 0;   /* 1 = 拒绝 P/R 指令（对端在行驶中重启过，锁定） */
volatile uint16_t g_adc_buffer[4];
/* USER CODE END PV */

void SystemClock_Config(void);
void MX_FREERTOS_Init(void);
/**
  * @brief  The application entry point.
  * @retval int
  */
int main(void)
{

  /* MCU Configuration--------------------------------------------------------*/

  /* Reset of all peripherals, Initializes the Flash interface and the Systick. */
  HAL_Init();

  /* Configure the system clock */
  SystemClock_Config();

  /* Initialize all configured peripherals */
  MX_GPIO_Init();
  MX_DMA_Init();
  MX_ADC1_Init();
  MX_IWDG_Init();
  MX_TIM3_Init();
  MX_USART1_UART_Init();
  MX_FDCAN2_Init();
  /* USER CODE BEGIN 2 */
  HAL_TIM_PWM_Start(&htim3, TIM_CHANNEL_1);   /* 舵机：TIM3_CH1 → PE2，50Hz */
  Motor_Init();                               /* 电机：先输出最小油门 1000us 再开 CH2，等电调解锁 */
  HAL_ADC_Start_DMA(&hadc1, (uint32_t *)g_adc_buffer, 4);
  /* USER CODE END 2 */

  /* Init scheduler */
  osKernelInitialize();  /* Call init function for freertos objects (in cmsis_os2.c) */
  MX_FREERTOS_Init();

  /* Start scheduler */
  osKernelStart();

  /* We should never get here as control is now taken by the scheduler */

  /* Infinite loop */
  /* USER CODE BEGIN WHILE */
  while (1)
  {
    /* USER CODE END WHILE */

    /* USER CODE BEGIN 3 */
  }
  /* USER CODE END 3 */
}

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
/**
  * @brief  Period elapsed callback in non blocking mode
  * @note   This function is called  when TIM2 interrupt took place, inside
  * HAL_TIM_IRQHandler(). It makes a direct call to HAL_IncTick() to increment
  * a global variable "uwTick" used as application time base.
  * @param  htim : TIM handle
  * @retval None
  */
void HAL_TIM_PeriodElapsedCallback(TIM_HandleTypeDef *htim)
{
  if (htim->Instance == TIM2)
  {
    HAL_IncTick();
  }
}

/**
  * @brief  This function is executed in case of error occurrence.
  * @retval None
  */
void Error_Handler(void)
{
  /* USER CODE BEGIN Error_Handler_Debug */
  /* User can add his own implementation to report the HAL error return state */
  __disable_irq();
  while (1)
  {
  }
  /* USER CODE END Error_Handler_Debug */
}
#ifdef USE_FULL_ASSERT
/**
  * @brief  Reports the name of the source file and the source line number
  *         where the assert_param error has occurred.
  * @param  file: pointer to the source file name
  * @param  line: assert_param error line source number
  * @retval None
  */
void assert_failed(uint8_t *file, uint32_t line)
{
  /* USER CODE BEGIN 6 */
  /* User can add his own implementation to report the file name and line number,
     ex: printf("Wrong parameters value: file %s on line %d\r\n", file, line) */
  /* USER CODE END 6 */
}
#endif /* USE_FULL_ASSERT */
