koko-PhyuHtwe/electronic-shifter-mbd/STM32G474VET6/ShiftByWire_HIL/ShiftByWire_HIL.ioc

Mcu.UserName=STM32G474VETx
PA0.Signal=ADC1_IN1
PA1.Signal=ADC1_IN2
PA10.Signal=USART1_RX
PA13.Signal=SYS_JTMS-SWDIO
PA14.Signal=SYS_JTCK-SWCLK
PA2.Signal=ADC1_IN3
PA3.Signal=ADC1_IN4
PA9.Signal=USART1_TX
PB12.GPIO_Label=CAN2_RX
PB12.Signal=FDCAN2_RX
PB13.GPIO_Label=CAN1_TX
PB13.Signal=FDCAN2_TX
PE0.GPIO_Label=BLUE
PE0.Signal=GPIO_Output
PE1.GPIO_Label=GREEN
PE1.Signal=GPIO_Output
PE2.Signal=S_TIM3_CH1
PE3.Signal=S_TIM3_CH2
PF0-OSC_IN.Signal=RCC_OSC_IN
PF1-OSC_OUT.Signal=RCC_OSC_OUT
