koko-PhyuHtwe/electronic-shifter-mbd/STM32G474VET6/ShiftByWire_HIL/Core/Inc/main.h

#define SPEED_STANDSTILL_KMH   (  5U )   /* 低于此速度视为已停车 */
#define SPEED_JUMP_MAX_KMH     ( 10U )   /* 单帧(10ms)车速下跌超过此值 → 不可能是真刹车 */
#define PARK_BRAKE_MIN_PCT     ( 30U )   /* 挂 P 挡要求的最低刹车力度 %，和 S32K 侧一致 */
#define CAN2_RX_Pin GPIO_PIN_12
#define CAN2_RX_GPIO_Port GPIOB
#define CAN1_TX_Pin GPIO_PIN_13
#define CAN1_TX_GPIO_Port GPIOB
#define BLUE_Pin GPIO_PIN_0
#define BLUE_GPIO_Port GPIOE
#define GREEN_Pin GPIO_PIN_1
#define GREEN_GPIO_Port GPIOE
