koko-PhyuHtwe/electronic-shifter-mbd/S32K144/freertos_s32k144/board/pin_mux.c

/* clang-format off */
/*
 * TEXT BELOW IS USED AS SETTING FOR TOOLS *************************************
!!GlobalInfo
product: Pins v9.0
processor: S32K144
package_id: S32K144_LQFP100
mcu_data: s32sdk_s32k1xx_rtm_402
processor_version: 0.0.0
pin_labels:
- {pin_num: '68', pin_signal: PTB12, label: BTN0, identifier: BTN0}
- {pin_num: '58', pin_signal: PTA6, label: MCU_ADC0_CH2}
- {pin_num: '57', pin_signal: PTA7, label: MCU_ADC0_CH3}
- {pin_num: '50', pin_signal: PTC12, label: MCU_KEY_1}
- {pin_num: '81', pin_signal: PTC6, label: MCU_LPUART1_RX_PC6}
- {pin_num: '80', pin_signal: PTC7, label: MCU_LPUART1_TX_PC7}
- {pin_num: '44', pin_signal: PTC16, label: MCU_CAN2_RX}
- {pin_num: '43', pin_signal: PTC17, label: MCU_CAN2_TX}
- {pin_num: '4', pin_signal: PTD0, label: MCU_LED_4_Y}
- {pin_num: '22', pin_signal: PTD15, label: MCU_LED_2_G}
- {pin_num: '21', pin_signal: PTD16, label: MCU_LED_1_B}
- {pin_num: '49', pin_signal: PTC13, label: MCU_KEY_2}
- {pin_num: '48', pin_signal: PTB2, label: MCU_KEY_3}
- {pin_num: '47', pin_signal: PTB3, label: MCU_KEY_4}
- {pin_num: '46', pin_signal: PTC14, label: MCU_KEY_5}
 * BE CAREFUL MODIFYING THIS COMMENT - IT IS YAML SETTINGS FOR TOOLS ***********
 */
/* clang-format on */

/**
 * @page misra_violations MISRA-C:2012 violations
 *
 * @section [global]
 * Violates MISRA 2012 Advisory Rule 8.7, External variable could be made static.
 * The external variables will be used in other source files in application code.
 *
 * @section [global]
 * Violates MISRA 2012 Advisory Rule 11.4, Conversion between a pointer and integer type.
 * The cast is required to initialize a pointer with an unsigned long define, representing an address.
 *
 * @section [global]
 * Violates MISRA 2012 Required Rule 11.6, Cast from unsigned int to pointer.
 * The cast is required to initialize a pointer with an unsigned long define, representing an address.
 *
 */

#include "pin_mux.h"

/* clang-format off */
/*
 * TEXT BELOW IS USED AS SETTING FOR TOOLS *************************************
BOARD_InitPins:
- options: {callFromInitBoot: 'true', coreID: core0}
- pin_list:
  - {pin_num: '21', peripheral: PORTD, signal: 'port, 16', pin_signal: PTD16, direction: OUTPUT}
  - {pin_num: '22', peripheral: PORTD, signal: 'port, 15', pin_signal: PTD15, direction: OUTPUT}
  - {pin_num: '58', peripheral: ADC0, signal: 'se, 2', pin_signal: PTA6}
  - {pin_num: '57', peripheral: ADC0, signal: 'se, 3', pin_signal: PTA7}
  - {pin_num: '50', peripheral: PORTC, signal: 'port, 12', pin_signal: PTC12, direction: INPUT, PS: state_1}
  - {pin_num: '81', peripheral: LPUART1, signal: rxd, pin_signal: PTC6}
  - {pin_num: '80', peripheral: LPUART1, signal: txd, pin_signal: PTC7, direction: OUTPUT}
  - {pin_num: '44', peripheral: CAN2, signal: 'rxd, rxd', pin_signal: PTC16}
  - {pin_num: '43', peripheral: CAN2, signal: 'txd, txd', pin_signal: PTC17}
  - {pin_num: '4', peripheral: PORTD, signal: 'port, 0', pin_signal: PTD0, direction: OUTPUT}
  - {pin_num: '49', peripheral: PORTC, signal: 'port, 13', pin_signal: PTC13, direction: INPUT, PS: state_1}
  - {pin_num: '47', peripheral: PORTB, signal: 'port, 3', pin_signal: PTB3, direction: INPUT, PS: state_1}
  - {pin_num: '46', peripheral: PORTC, signal: 'port, 14', pin_signal: PTC14, direction: INPUT, PS: state_1}
  - {pin_num: '29', peripheral: ADC0, signal: 'se, 11', pin_signal: PTC3}
  - {pin_num: '30', peripheral: ADC0, signal: 'se, 10', pin_signal: PTC2}
  - {pin_num: '28', peripheral: PORTB, signal: 'port, 4', pin_signal: PTB4, direction: INPUT, PE: state_1, PS: state_1}
  - {pin_num: '48', peripheral: PORTB, signal: 'port, 2', pin_signal: PTB2, direction: INPUT, PS: state_0}
 * BE CAREFUL MODIFYING THIS COMMENT - IT IS YAML SETTINGS FOR TOOLS ***********
 */
/* clang-format on */

/* Generate array of configured pin structures */
pin_settings_config_t g_pin_mux_InitConfigArr0[NUM_OF_CONFIGURED_PINS0] = {
    {
        .base            = PORTA,
        .pinPortIdx      = 6U,
        .pullConfig      = PORT_INTERNAL_PULL_NOT_ENABLED,
        .driveSelect     = PORT_LOW_DRIVE_STRENGTH,
        .passiveFilter   = false,
        .mux             = PORT_PIN_DISABLED,
        .pinLock         = false,
        .intConfig       = PORT_DMA_INT_DISABLED,
        .clearIntFlag    = false,
        .gpioBase        = NULL,
        .digitalFilter   = false,
    },
    {
        .base            = PORTA,
        .pinPortIdx      = 7U,
        .pullConfig      = PORT_INTERNAL_PULL_NOT_ENABLED,
        .driveSelect     = PORT_LOW_DRIVE_STRENGTH,
        .passiveFilter   = false,
        .mux             = PORT_PIN_DISABLED,
        .pinLock         = false,
        .intConfig       = PORT_DMA_INT_DISABLED,
        .clearIntFlag    = false,
        .gpioBase        = NULL,
        .digitalFilter   = false,
    },
    {
        .base            = PORTB,
        .pinPortIdx      = 2U,
        .pullConfig      = PORT_INTERNAL_PULL_NOT_ENABLED,
        .driveSelect     = PORT_LOW_DRIVE_STRENGTH,
        .passiveFilter   = false,
        .mux             = PORT_MUX_AS_GPIO,
        .pinLock         = false,
        .intConfig       = PORT_DMA_INT_DISABLED,
        .clearIntFlag    = false,
        .gpioBase        = PTB,
        .direction       = GPIO_INPUT_DIRECTION,
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
        .initValue       = 0U,
    },
};
/***********************************************************************************************************************
 * EOF
 **********************************************************************************************************************/
