koko-PhyuHtwe/electronic-shifter-mbd/S32K144/freertos_s32k144/board/clock_config.c

/**
* @page misra_violations MISRA-C:2012 violations
*
* @section [global]
* Violates MISRA 2012 Required Rule 9.4, Duplicate initialization of object element.
* It's the only way to initialize an array that is member of struct.
*
* @section [global]
* Violates MISRA 2012 Advisory Rule 8.7, External variable could be made static.
* The external variables will be used in other source files in application code.
*/

/* TEXT BELOW IS USED AS SETTING FOR TOOLS *************************************
!!GlobalInfo
product: Clocks v7.0
processor: S32K144
package_id: S32K144_LQFP100
mcu_data: s32sdk_s32k1xx_rtm_402
processor_version: 0.0.0
 * BE CAREFUL MODIFYING THIS COMMENT - IT IS YAML SETTINGS FOR TOOLS **********/

#include "clock_config.h"

/*******************************************************************************
 * Definitions
 ******************************************************************************/

/*******************************************************************************
 * Variables
 ******************************************************************************/

/* TEXT BELOW IS USED AS SETTING FOR TOOLS *************************************
!!Configuration
name: BOARD_BootClockRUN
called_from_default_init: true
outputs:
- {id: ADC0_CLK.outFreq, value: 8 MHz}
- {id: ADC1_CLK.outFreq, value: 8 MHz}
- {id: BUS_CLK.outFreq, value: 40 MHz}
- {id: CLKOUT.outFreq, value: 48 MHz}
- {id: CMP0_CLK.outFreq, value: 40 MHz}
- {id: CORE_CLK.outFreq, value: 80 MHz, locked: true, accuracy: '0.001'}
- {id: CRC0_CLK.outFreq, value: 40 MHz}
- {id: DMA0_CLK.outFreq, value: 80 MHz}
- {id: DMAMUX0_CLK.outFreq, value: 40 MHz}
- {id: EIM0_CLK.outFreq, value: 80 MHz}
- {id: ERM0_CLK.outFreq, value: 80 MHz}
- {id: EWM0_CLK.outFreq, value: 40 MHz}
- {id: FIRCDIV1_CLK.outFreq, value: 48 MHz}
- {id: FIRCDIV2_CLK.outFreq, value: 48 MHz}
- {id: FLASH_CLK.outFreq, value: 20 MHz}
- {id: FLEXCAN0_CLK.outFreq, value: 80 MHz}
- {id: FLEXCAN1_CLK.outFreq, value: 80 MHz}
- {id: FLEXCAN2_CLK.outFreq, value: 80 MHz}
- {id: FTFC0_CLK.outFreq, value: 20 MHz}
- {id: FTM0_CLK.outFreq, value: 8 MHz}
- {id: FTM1_CLK.outFreq, value: 8 MHz}
- {id: FTM2_CLK.outFreq, value: 8 MHz}
- {id: FTM3_CLK.outFreq, value: 8 MHz}
- {id: FlexIO0_CLK.outFreq, value: 8 MHz}
- {id: LPI2C0_CLK.outFreq, value: 8 MHz}
- {id: LPIT0_CLK.outFreq, value: 8 MHz}
- {id: LPO_1K_CLK.outFreq, value: 1 kHz}
- {id: LPO_CLK.outFreq, value: 128 kHz}
- {id: LPSPI0_CLK.outFreq, value: 8 MHz}
- {id: LPSPI1_CLK.outFreq, value: 8 MHz}
- {id: LPSPI2_CLK.outFreq, value: 8 MHz}
- {id: LPTMR0_CLK.outFreq, value: 8 MHz}
- {id: LPUART0_CLK.outFreq, value: 8 MHz}
- {id: LPUART1_CLK.outFreq, value: 8 MHz}
- {id: LPUART2_CLK.outFreq, value: 8 MHz}
- {id: MPU0_CLK.outFreq, value: 80 MHz}
- {id: MSCM0_CLK.outFreq, value: 80 MHz}
- {id: PDB0_CLK.outFreq, value: 80 MHz}
- {id: PDB1_CLK.outFreq, value: 80 MHz}
- {id: PORTA_CLK.outFreq, value: 40 MHz}
- {id: PORTB_CLK.outFreq, value: 40 MHz}
- {id: PORTC_CLK.outFreq, value: 40 MHz}
- {id: PORTD_CLK.outFreq, value: 40 MHz}
- {id: PORTE_CLK.outFreq, value: 40 MHz}
- {id: RTC0_CLK.outFreq, value: 40 MHz}
- {id: RTC_CLK.outFreq, value: 48 MHz}
- {id: SCGCLKOUT.outFreq, value: 48 MHz}
- {id: SIRCDIV1_CLK.outFreq, value: 8 MHz}
- {id: SIRCDIV2_CLK.outFreq, value: 8 MHz}
- {id: SOSCDIV1_CLK.outFreq, value: 8 MHz}
- {id: SOSCDIV2_CLK.outFreq, value: 8 MHz}
- {id: SPLLDIV1_CLK.outFreq, value: 80 MHz}
- {id: SPLLDIV2_CLK.outFreq, value: 40 MHz}
- {id: SPLL_CLK_OUT.outFreq, value: 160 MHz}
- {id: SYS_CLK.outFreq, value: 80 MHz}
- {id: TRACE_CLK.outFreq, value: 80 MHz}
settings:
- {id: 'HSRUN:SCG.DIVBUS.scale', value: '2', locked: true}
- {id: 'HSRUN:SCG.DIVCORE.scale', value: '2', locked: true}
- {id: 'HSRUN:SCG.DIVSLOW.scale', value: '4', locked: true}
- {id: 'HSRUN:SCG.SCSSEL.sel', value: SCG.SPLL_CLK}
- {id: PCC.LPTMR0_FRAC.scale, value: '1', locked: true}
- {id: PCC.LPUART0_CLK_SEL.sel, value: SCG.SOSCDIV2_CLK}
- {id: PCC.LPUART1_CLK_SEL.sel, value: SCG.SOSCDIV2_CLK}
- {id: PCC.LPUART2_CLK_SEL.sel, value: SCG.SOSCDIV2_CLK}
- {id: PCC.PREDIV.scale, value: '1', locked: true}
- {id: PCC.PREDIVTRACE.scale, value: '1', locked: true}
- {id: PCC.TRACE_FRAC.scale, value: '1', locked: true}
- {id: RTCCLKSEL.sel, value: SCG.FIRCDIV1_CLK}
- {id: 'RUN:SCG.DIVBUS.scale', value: '2', locked: true}
- {id: 'RUN:SCG.DIVCORE.scale', value: '2', locked: true}
- {id: 'RUN:SCG.DIVSLOW.scale', value: '4', locked: true}
- {id: 'RUN:SCG.SCSSEL.sel', value: SCG.SPLL_CLK}
- {id: SCG.DIVBUS.scale, value: '2', locked: true}
- {id: SCG.DIVCORE.scale, value: '2', locked: true}
- {id: SCG.DIVSLOW.scale, value: '4', locked: true}
- {id: SCG.FIRCDIV1.scale, value: '1', locked: true}
- {id: SCG.FIRCDIV2.scale, value: '1', locked: true}
- {id: SCG.PREDIV.scale, value: '1', locked: true}
- {id: SCG.SCSSEL.sel, value: SCG.SPLL_CLK}
- {id: SCG.SIRCDIV1.scale, value: '1', locked: true}
- {id: SCG.SIRCDIV2.scale, value: '1', locked: true}
- {id: SCG.SOSCDIV1.scale, value: '1', locked: true}
- {id: SCG.SOSCDIV2.scale, value: '1', locked: true}
- {id: SCG.SPLLDIV1.scale, value: '2', locked: true}
- {id: SCG.SPLLDIV2.scale, value: '4', locked: true}
- {id: SCG.SPLL_mul.scale, value: '40', locked: true}
- {id: 'VLPR:SCG.DIVBUS.scale', value: '1', locked: true}
- {id: 'VLPR:SCG.DIVCORE.scale', value: '2', locked: true}
- {id: 'VLPR:SCG.DIVSLOW.scale', value: '4', locked: true}
- {id: 'VLPR:SCG.SCSSEL.sel', value: SCG.SIRC}
 * BE CAREFUL MODIFYING THIS COMMENT - IT IS YAML SETTINGS FOR TOOLS **********/

/* *************************************************************************
* Configuration structure for peripheral clock configuration 0
* ************************************************************************* */
/*! @brief peripheral clock configuration 0 */
peripheral_clock_config_t peripheralClockConfig0[NUM_OF_PERIPHERAL_CLOCKS_0] = {
    {
        .clockName = ADC0_CLK,
        .clkGate = true,
        .clkSrc = CLK_SRC_SIRC_DIV2,
        .frac = MULTIPLY_BY_ONE,
        .divider = DIVIDE_BY_ONE,
    },
    {
        .clockName = ADC1_CLK,
        .clkGate = true,
        .clkSrc = CLK_SRC_SIRC_DIV2,
        .frac = MULTIPLY_BY_ONE,
        .divider = DIVIDE_BY_ONE,
    },
    {
        .clockName = LPSPI0_CLK,
        .clkGate = true,
        .clkSrc = CLK_SRC_SIRC_DIV2,
        .frac = MULTIPLY_BY_ONE,
        .divider = DIVIDE_BY_ONE,
    },
    {
        .clockName = LPSPI1_CLK,
        .clkGate = true,
        .clkSrc = CLK_SRC_SIRC_DIV2,
        .frac = MULTIPLY_BY_ONE,
        .divider = DIVIDE_BY_ONE,
    },
    {
        .clockName = LPSPI2_CLK,
        .clkGate = true,
        .clkSrc = CLK_SRC_SIRC_DIV2,
        .frac = MULTIPLY_BY_ONE,
        .divider = DIVIDE_BY_ONE,
    },
    {
        .clockName = LPUART0_CLK,
        .clkGate = true,
        .clkSrc = CLK_SRC_SOSC_DIV2,
        .frac = MULTIPLY_BY_ONE,
        .divider = DIVIDE_BY_ONE,
    },
    {
        .clockName = LPUART1_CLK,
        .clkGate = true,
        .clkSrc = CLK_SRC_SOSC_DIV2,
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
        .clockName = PORTE_CLK,
        .clkGate = true,
        .clkSrc = CLK_SRC_OFF,
        .frac = MULTIPLY_BY_ONE,
        .divider = DIVIDE_BY_ONE,
    },
};
/* *************************************************************************
* Configuration structure for Clock Configuration 0
* ************************************************************************* */
/*! @brief User Configuration structure clock_managerCfg_0 */
clock_manager_user_config_t clockMan1_InitConfig0 = {
    .scgConfig =
    {
        .sircConfig =
        {
            .initialize = true,
            .enableInStop = true,                 /* Enable SIRC in stop mode */
            .enableInLowPower = true,             /* Enable SIRC in low power mode */
            .locked = false,                      /* unlocked */
            .range = SCG_SIRC_RANGE_HIGH,         /* Slow IRC high range clock (8 MHz) */
            .div1 = SCG_ASYNC_CLOCK_DIV_BY_1,     /* Slow IRC Clock Divider 1: divided by 1 */
            .div2 = SCG_ASYNC_CLOCK_DIV_BY_1,     /* Slow IRC Clock Divider 3: divided by 1 */
        },
        .fircConfig =
        {
            .initialize = true,
            .regulator = true,                    /* FIRC regulator is enabled */
            .locked = false,                      /* unlocked */
            .range = SCG_FIRC_RANGE_48M,           /*!< RANGE      */
            .div1 = SCG_ASYNC_CLOCK_DIV_BY_1,     /* Fast IRC Clock Divider 1: divided by 1 */
            .div2 = SCG_ASYNC_CLOCK_DIV_BY_1,     /* Fast IRC Clock Divider 3: divided by 1 */
        },
        .rtcConfig =
        {
            .initialize = false,
        },
        .soscConfig =
        {
            .initialize = true,
            .freq = 8000000U,                     /* System Oscillator frequency: 8000000Hz */
            .monitorMode = SCG_SOSC_MONITOR_DISABLE,/* Monitor disabled */
            .locked = false,                      /* SOSC disabled */
            .extRef = SCG_SOSC_REF_OSC,           /* Internal oscillator of OSC requested. */
            .gain = SCG_SOSC_GAIN_LOW,            /* Configure crystal oscillator for low-gain operation */
            .range = SCG_SOSC_RANGE_HIGH,         /* High frequency range selected for the crystal oscillator of 8 MHz to 40 MHz. */
            .div1 = SCG_ASYNC_CLOCK_DIV_BY_1,     /* System OSC Clock Divider 1: divided by 1 */
            .div2 = SCG_ASYNC_CLOCK_DIV_BY_1,     /* System OSC Clock Divider 3: divided by 1 */
        },
        .spllConfig =
        {
            .initialize = true,
            .monitorMode = SCG_SPLL_MONITOR_DISABLE,/* Monitor disabled */
            .locked = false,                      /* unlocked */
            .prediv = (uint8_t)SCG_SPLL_CLOCK_PREDIV_BY_1,/* Divided by 1 */
            .mult = (uint8_t)SCG_SPLL_CLOCK_MULTIPLY_BY_40,/* Multiply Factor is 40 */
            .src = 0U,
            .div1 = SCG_ASYNC_CLOCK_DIV_BY_2,     /* System PLL Clock Divider 1: divided by 2 */
            .div2 = SCG_ASYNC_CLOCK_DIV_BY_4,     /* System PLL Clock Divider 3: divided by 4 */
        },
        .clockOutConfig =
        {
            .initialize = true,
            .source = SCG_CLOCKOUT_SRC_FIRC,      /* Fast IRC. */
        },
        .clockModeConfig =
        {
            .initialize = true,
            .rccrConfig =
            {
                .src = SCG_SYSTEM_CLOCK_SRC_SYS_PLL,/* System PLL */
                .divCore = SCG_SYSTEM_CLOCK_DIV_BY_2,/* Core Clock Divider: divided by 2 */
                .divBus = SCG_SYSTEM_CLOCK_DIV_BY_2,/* Bus Clock Divider: divided by 2 */
                .divSlow = SCG_SYSTEM_CLOCK_DIV_BY_4,/* Slow Clock Divider: divided by 4 */
            },
            .vccrConfig =
            {
                .src = SCG_SYSTEM_CLOCK_SRC_SIRC,/* Slow SIRC */
                .divCore = SCG_SYSTEM_CLOCK_DIV_BY_2,/* Core Clock Divider: divided by 2 */
                .divBus = SCG_SYSTEM_CLOCK_DIV_BY_1,/* Bus Clock Divider: divided by 1 */
                .divSlow = SCG_SYSTEM_CLOCK_DIV_BY_4,/* Slow Clock Divider: divided by 4 */
            },
            .hccrConfig =
            {
                .src = SCG_SYSTEM_CLOCK_SRC_SYS_PLL,/* System PLL */
                .divCore = SCG_SYSTEM_CLOCK_DIV_BY_2,/* Core Clock Divider: divided by 2 */
                .divBus = SCG_SYSTEM_CLOCK_DIV_BY_2,/* Bus Clock Divider: divided by 2 */
                .divSlow = SCG_SYSTEM_CLOCK_DIV_BY_4,/* Slow Clock Divider: divided by 4 */
            },
        },
    },
    .pccConfig =
    {
        .peripheralClocks = peripheralClockConfig0, /*!< Peripheral clock control configurations  */
        .count = NUM_OF_PERIPHERAL_CLOCKS_0, /*!< Number of the peripheral clock control configurations  */
    },
    .simConfig =
    {
        .clockOutConfig =
        {
            .initialize = true, /*!< Initialize    */
            .enable = true,                       /* enabled */
            .source = SIM_CLKOUT_SEL_SYSTEM_SCG_CLKOUT,/* SCG CLKOUT clock select: SCG slow clock */
            .divider = SIM_CLKOUT_DIV_BY_1,       /* Divided by 1 */
        },
        .lpoClockConfig =
        {
            .initialize = true, /*!< Initialize    */
            .enableLpo1k = true, /*!< LPO1KCLKEN    */
            .enableLpo32k = true, /*!< LPO32KCLKEN   */
            .sourceLpoClk = SIM_LPO_CLK_SEL_LPO_128K,/* 128 kHz LPO clock */
            .sourceRtcClk = SIM_RTCCLK_SEL_FIRCDIV1_CLK,/* FIRCDIV1 clock */
        },
        .platGateConfig =
        {
            .initialize = true, /*!< Initialize    */
            .enableEim = true, /*!< CGCEIM        */
            .enableErm = true, /*!< CGCERM        */
            .enableDma = true, /*!< CGCDMA        */
            .enableMpu = true, /*!< CGCMPU        */
            .enableMscm = true, /*!< CGCMSCM       */
        },
        .tclkConfig =
        {
            .initialize = false, /*!< Initialize    */
        },
        .traceClockConfig =
        {
            .initialize = true, /*!< Initialize    */
            .divEnable = true, /*!< TRACEDIVEN    */
            .source = CLOCK_TRACE_SRC_CORE_CLK, /*!< TRACECLK_SEL  */
            .divider = 0U, /*!< TRACEDIV      */
            .divFraction = false, /*!< TRACEFRAC     */
        },
    },
    .pmcConfig =
    {
        .lpoClockConfig =
        {
        .initialize = true,  /*!< Initialize    */
        .enable = true, /*!< Enable/disable LPO     */
        .trimValue = 0, /*!< Trimming value for LPO */
        },
    },
};

/*! @brief Array of pointers to User configuration structures */
clock_manager_user_config_t const * g_clockManConfigsArr[] = {
&clockMan1_InitConfig0
};

/*! @brief Array of pointers to User defined Callbacks configuration structures */
/* The tool do not support generate Callbacks configuration. It's always empty. */
clock_manager_callback_user_config_t * g_clockManCallbacksArr[] = {(void*)0};
