koko-PhyuHtwe/electronic-shifter-mbd/(commit log)

2026-09-02 v0.1.0 三段式版本说明: [MATLAB.S32K144.G474] [公开仓库版已脱敏]
    - MATLAB 0 : 仅提交 GearShift_Stateflow 模型骨架 + Simulink 代码生成产物（_ert_rtw/*.c/h），状态机迁移条件与完整档位逻辑待后续实现。删除一次性脚本 read_docx.py（含本地路径/姓名硬编码）。SBW_项目计划书作者脱敏为方向描述
    - S32K144 1 : FreeRTOS 基础外设已验证。① 蓝心跳 LED(PTD16) 500ms；② FlexCAN2 中断收 0x280 环形队列，满 20 帧翻转绿灯(PTD15)；③ PTC12 解锁按键 10ms 消抖，按下串口屏打印+灭故障灯(PTD0)；④ LPUART1 + HMI Nextion 协议（SendNumber/SendFloat/GetFrame）串口屏可用。vTask_ADC/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
2026-09-02 v0.1.0 三段式版本说明: [MATLAB.S32K144.G474] 做了adc
2026-09-03 v1.1.0 三段式版本说明: [MATLAB.S32K144.G474] matlab基本完成
2026-09-04 v1.2.1 三段式版本说明: [MATLAB.S32K144.G474] 项目总体完成，增加474的安全保护
2026-11-06 v2.3.2 三段式版本说明: [MATLAB.S32K144.G474] 项目总体完成，增加开环电机,完善仿真过的逻辑.
2026-11-06 新增README
