koko-PhyuHtwe/electronic-shifter-mbd/(notices)

Notices in the files:
STM32G474VET6/ShiftByWire_HIL/Core/Src/app_freertos.c:
Copyright (c) 2026 STMicroelectronics.
All rights reserved.
This software is licensed under terms that can be found in the LICENSE file
